hoglet67/ElectronFpga/pcb/README.md

# ElectronFpga/pcb

This is a PCB for the Electron ULA replacement project (the "Ultimate Electron Upgrade").

Stardot thread:
https://stardot.org.uk/forums/viewtopic.php?f=3&t=9223

Status: v1 board sent to fab!

Pictures
--------

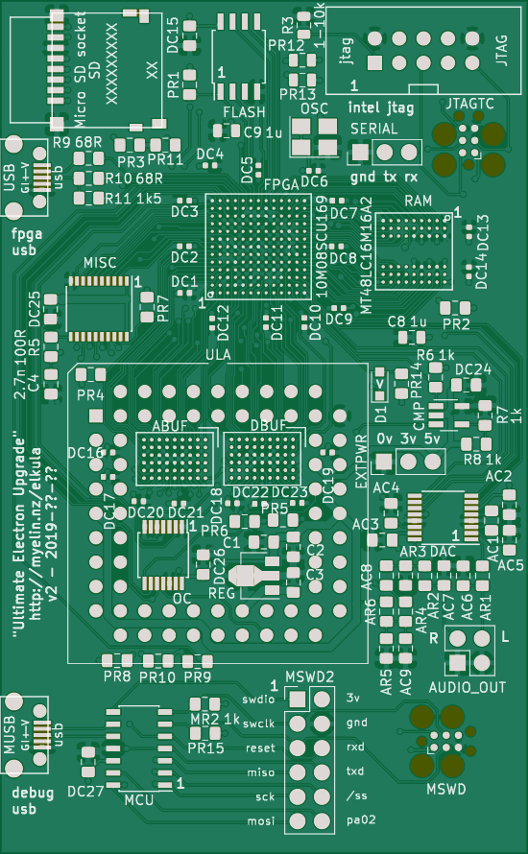
[picture p1: pcb/pcb-front.png]
PCB front


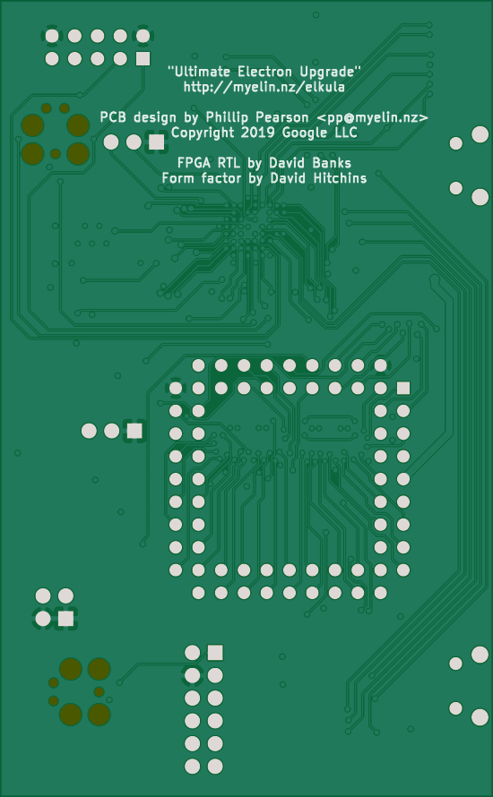
[picture p2: pcb/pcb-back.png]
PCB back
