hoglet67/ElectronFpga/rgb_to_vga_pcb/pcb-back.png

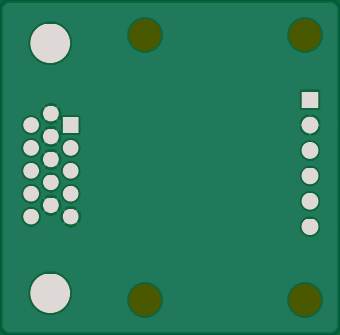
rgb_to_vga_pcb/pcb-back.png
