hoglet67/ElectronFpga/rgb_to_vga_pcb/pcb-front.png

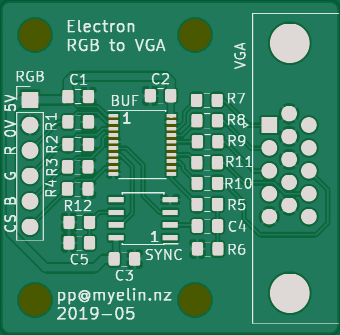
rgb_to_vga_pcb/pcb-front.png
