hoglet67/ElectronFpga/pcb/readable_bill_of_materials.txt

This is the human-readable bill of materials.
See bill_of_materials.txt for a terser version suitable for spreadsheet import.

DC1
- Value: 100n
- Description: Capacitor 0402: 100n
- KiCad package: Capacitor_SMD:C_0402_1005Metric

DC10
- Value: 100n
- Description: Capacitor 0402: 100n
- KiCad package: Capacitor_SMD:C_0402_1005Metric

DC11
- Value: 100n
- Description: Capacitor 0402: 100n
- KiCad package: Capacitor_SMD:C_0402_1005Metric

DC12
- Value: 100n
- Description: Capacitor 0402: 100n
- KiCad package: Capacitor_SMD:C_0402_1005Metric

DC13
- Value: 100n
- Description: Capacitor 0402: 100n
- KiCad package: Capacitor_SMD:C_0402_1005Metric

DC14
- Value: 100n
- Description: Capacitor 0402: 100n
- KiCad package: Capacitor_SMD:C_0402_1005Metric

DC16
- Value: 100n
- Description: Capacitor 0402: 100n
- KiCad package: Capacitor_SMD:C_0402_1005Metric

DC17
- Value: 100n
- Description: Capacitor 0402: 100n
- KiCad package: Capacitor_SMD:C_0402_1005Metric

DC18
- Value: 100n
- Description: Capacitor 0402: 100n
- KiCad package: Capacitor_SMD:C_0402_1005Metric

DC19
- Value: 100n
- Description: Capacitor 0402: 100n
- KiCad package: Capacitor_SMD:C_0402_1005Metric

DC2
- Value: 100n
- Description: Capacitor 0402: 100n
- KiCad package: Capacitor_SMD:C_0402_1005Metric

DC20
- Value: 100n
- Description: Capacitor 0402: 100n
- KiCad package: Capacitor_SMD:C_0402_1005Metric

DC21
- Value: 100n
- Description: Capacitor 0402: 100n
- KiCad package: Capacitor_SMD:C_0402_1005Metric

DC22
- Value: 100n
- Description: Capacitor 0402: 100n
- KiCad package: Capacitor_SMD:C_0402_1005Metric

DC23
- Value: 100n
- Description: Capacitor 0402: 100n
- KiCad package: Capacitor_SMD:C_0402_1005Metric

DC3
- Value: 100n
- Description: Capacitor 0402: 100n
- KiCad package: Capacitor_SMD:C_0402_1005Metric

DC4
- Value: 100n
- Description: Capacitor 0402: 100n
- KiCad package: Capacitor_SMD:C_0402_1005Metric

DC5
- Value: 100n
- Description: Capacitor 0402: 100n
- KiCad package: Capacitor_SMD:C_0402_1005Metric

DC6
- Value: 100n
- Description: Capacitor 0402: 100n
- KiCad package: Capacitor_SMD:C_0402_1005Metric

DC7
- Value: 100n
- Description: Capacitor 0402: 100n
- KiCad package: Capacitor_SMD:C_0402_1005Metric

DC8
- Value: 100n
- Description: Capacitor 0402: 100n
- KiCad package: Capacitor_SMD:C_0402_1005Metric

DC9
- Value: 100n
- Description: Capacitor 0402: 100n
- KiCad package: Capacitor_SMD:C_0402_1005Metric

DC15
- Value: 100n
- Description: Capacitor 0805: 100n
- KiCad package: Capacitor_SMD:C_0805_2012Metric_Pad1.15x1.40mm_HandSolder

DC24
- Value: 100n
- Description: Capacitor 0805: 100n
- KiCad package: Capacitor_SMD:C_0805_2012Metric_Pad1.15x1.40mm_HandSolder

DC25
- Value: 100n
- Description: Capacitor 0805: 100n
- KiCad package: Capacitor_SMD:C_0805_2012Metric_Pad1.15x1.40mm_HandSolder

DC26
- Value: 100n
- Description: Capacitor 0805: 100n
- KiCad package: Capacitor_SMD:C_0805_2012Metric_Pad1.15x1.40mm_HandSolder

DC27
- Value: 100n
- Description: Capacitor 0805: 100n
- KiCad package: Capacitor_SMD:C_0805_2012Metric_Pad1.15x1.40mm_HandSolder

AC8
- Value: 10u
- Description: Capacitor 0805: 10u
- KiCad package: Capacitor_SMD:C_0805_2012Metric_Pad1.15x1.40mm_HandSolder

AC9
- Value: 10u
- Description: Capacitor 0805: 10u
- KiCad package: Capacitor_SMD:C_0805_2012Metric_Pad1.15x1.40mm_HandSolder

C1
- Value: 10u
- Description: Capacitor 0805: 10u
- KiCad package: Capacitor_SMD:C_0805_2012Metric_Pad1.15x1.40mm_HandSolder

AC1
- Value: 1u
- Description: Capacitor 0805: 1u
- KiCad package: Capacitor_SMD:C_0805_2012Metric_Pad1.15x1.40mm_HandSolder

AC5
- Value: 1u
- Description: Capacitor 0805: 1u
- KiCad package: Capacitor_SMD:C_0805_2012Metric_Pad1.15x1.40mm_HandSolder

C2
- Value: 1u
- Description: Capacitor 0805: 1u
- KiCad package: Capacitor_SMD:C_0805_2012Metric_Pad1.15x1.40mm_HandSolder

C3
- Value: 1u
- Description: Capacitor 0805: 1u
- KiCad package: Capacitor_SMD:C_0805_2012Metric_Pad1.15x1.40mm_HandSolder

C8
- Value: 1u
- Description: Capacitor 0805: 1u
- KiCad package: Capacitor_SMD:C_0805_2012Metric

C9
- Value: 1u
- Description: Capacitor 0805: 1u
- KiCad package: Capacitor_SMD:C_0805_2012Metric

AC4
- Value: 2.2u
- Description: Capacitor 0805: 2.2u
- KiCad package: Capacitor_SMD:C_0805_2012Metric_Pad1.15x1.40mm_HandSolder

C4
- Value: 2.7n
- Description: Capacitor 0805: 2.7n
- KiCad package: Capacitor_SMD:C_0805_2012Metric_Pad1.15x1.40mm_HandSolder

AC6
- Value: 2.7n NF
- Description: Capacitor 0805: 2.7n NF
- KiCad package: Capacitor_SMD:C_0805_2012Metric_Pad1.15x1.40mm_HandSolder

AC7
- Value: 2.7n NF
- Description: Capacitor 0805: 2.7n NF
- KiCad package: Capacitor_SMD:C_0805_2012Metric_Pad1.15x1.40mm_HandSolder

AC2
- Value: 4.7u
- Description: Capacitor 0805: 4.7u
- KiCad package: Capacitor_SMD:C_0805_2012Metric_Pad1.15x1.40mm_HandSolder

AC3
- Value: 4.7u
- Description: Capacitor 0805: 4.7u
- KiCad package: Capacitor_SMD:C_0805_2012Metric_Pad1.15x1.40mm_HandSolder

D1
- Value: BAT54
- Description: Diode SOD323: BAT54
- KiCad package: Diode_SMD:D_SOD-323_HandSoldering

FLASH
- Value: W25Q128JVSIM
- Description: IC 128Mbit QSPI flash; https://www.digikey.com/product-detail/en/winbond-electronics/W25Q128JVSIM/W25Q128JVSIM-ND/6819721
- KiCad package: Package_SO:SOIJ-8_5.3x5.3mm_P1.27mm

MCU
- Value: atsamd11c
- Description: IC ARM MCU; https://www.digikey.com/product-detail/en/microchip-technology/ATSAMD11C14A-SSUT/ATSAMD11C14A-SSUTCT-ND
- KiCad package: Package_SO:SOIC-14_3.9x8.7mm_P1.27mm

DAC
- Value: WM8524CGEDT
- Description: IC Audio DAC; https://www.digikey.com/product-detail/en/cirrus-logic-inc/WM8524CGEDT/598-2458-ND
- KiCad package: Package_SO:TSSOP-16_4.4x5mm_P0.65mm

CMP
- Value: MIC7221YM5-TR
- Description: IC Comparator; https://www.digikey.com/product-detail/en/microchip-technology/MIC7221YM5-TR/576-2901-1-ND
- KiCad package: Package_TO_SOT_SMD:SOT-23-5_HandSoldering

FPGA
- Value: 10M08SCU169
- Description: IC FPGA Intel Max 10; https://www.digikey.com/product-detail/en/10M08SCU169C8G/544-3270-ND
- KiCad package: myelin-kicad:intel_ubga169

REG
- Value: AP7365-33YG-XX
- Description: IC LDO 3.3V regulator; https://www.digikey.com/products/en?keywords=AP7365-33YG-13DICT-ND
- KiCad package: Package_TO_SOT_SMD:SOT-89-3

RAM
- Value: MT48LC16M16A2
- Description: IC SDRAM 32MB; MT48LC16M16A2F4-6A:GTR
- KiCad package: myelin-kicad:sdram_54tfbga

ABUF
- Value: 74LVTH162245ZRDR
- Description: IC buffer 16-bit; https://www.digikey.com/product-detail/en/texas-instruments/74LVTH162245ZRDR/296-16878-1-ND
- KiCad package: myelin-kicad:ti_zrd_54_pbga

DBUF
- Value: 74LVTH162245ZRDR
- Description: IC buffer 16-bit; https://www.digikey.com/product-detail/en/texas-instruments/74LVTH162245ZRDR/296-16878-1-ND
- KiCad package: myelin-kicad:ti_zrd_54_pbga

OC
- Value: 74HCT125PW
- Description: IC buffer 4-bit OC; https://www.digikey.com/product-detail/en/nexperia-usa-inc/74HCT125PW112/1727-6443-ND
- KiCad package: Package_SO:TSSOP-14_4.4x5mm_P0.65mm

MISC
- Value: 74HCT245PW
- Description: IC buffer 8-bit; https://www.digikey.com/product-detail/en/nexperia-usa-inc/74HCT245PW118/1727-6353-1-ND
- KiCad package: Package_SO:SSOP-20_4.4x6.5mm_P0.65mm

OSC
- Value: osc
- Description: IC oscillator 16MHz; https://www.digikey.com/product-detail/en/microchip-technology/DSC1001CL1-016.0000/DSC1001CL1-016.0000-ND
- KiCad package: Oscillator:Oscillator_SMD_Abracon_ASE-4Pin_3.2x2.5mm_HandSoldering

AUDIO_OUT
- Value: audio out
- Description: Pin header
- KiCad package: Connector_PinHeader_2.54mm:PinHeader_2x02_P2.54mm_Vertical

SERIAL
- Value: fpga serial port
- Description: Pin header
- KiCad package: Connector_PinHeader_2.54mm:PinHeader_1x03_P2.54mm_Vertical

JTAG
- Value: jtag
- Description: Pin header
- KiCad package: myelin-kicad:jtag_shrouded_2x5

MSWD2
- Value: swd
- Description: Pin header
- KiCad package: Connector_PinHeader_2.54mm:PinHeader_2x06_P2.54mm_Vertical

EXTPWR
- Value: ext pwr
- Description: Pin header - 1x3 0.1 inch male
- KiCad package: Connector_PinHeader_2.54mm:PinHeader_1x03_P2.54mm_Vertical

ULA
- Value: ULA header
- Description: Pin header - round - to plug into an Acorn Electron ULA socket
- KiCad package: modified-kicad:PLCC-68_THT-Socket-Electron-ULA

R3
- Value: 1-10k
- Description: Resistor 0805: 1-10k
- KiCad package: Resistor_SMD:R_0805_2012Metric

R5
- Value: 100R
- Description: Resistor 0805: 100R
- KiCad package: Resistor_SMD:R_0805_2012Metric_Pad1.15x1.40mm_HandSolder

AR4
- Value: 10k
- Description: Resistor 0805: 10k
- KiCad package: Resistor_SMD:R_0805_2012Metric_Pad1.15x1.40mm_HandSolder

AR5
- Value: 10k
- Description: Resistor 0805: 10k
- KiCad package: Resistor_SMD:R_0805_2012Metric_Pad1.15x1.40mm_HandSolder

AR6
- Value: 10k
- Description: Resistor 0805: 10k
- KiCad package: Resistor_SMD:R_0805_2012Metric_Pad1.15x1.40mm_HandSolder

PR1
- Value: 10k
- Description: Resistor 0805: 10k
- KiCad package: Resistor_SMD:R_0805_2012Metric_Pad1.15x1.40mm_HandSolder

PR10
- Value: 10k
- Description: Resistor 0805: 10k
- KiCad package: Resistor_SMD:R_0805_2012Metric_Pad1.15x1.40mm_HandSolder

PR12
- Value: 10k
- Description: Resistor 0805: 10k
- KiCad package: Resistor_SMD:R_0805_2012Metric

PR13
- Value: 10k
- Description: Resistor 0805: 10k
- KiCad package: Resistor_SMD:R_0805_2012Metric

PR14
- Value: 10k
- Description: Resistor 0805: 10k
- KiCad package: Resistor_SMD:R_0805_2012Metric_Pad1.15x1.40mm_HandSolder

PR15
- Value: 10k
- Description: Resistor 0805: 10k
- KiCad package: Resistor_SMD:R_0805_2012Metric_Pad1.15x1.40mm_HandSolder

PR2
- Value: 10k
- Description: Resistor 0805: 10k
- KiCad package: Resistor_SMD:R_0805_2012Metric_Pad1.15x1.40mm_HandSolder

PR3
- Value: 10k
- Description: Resistor 0805: 10k
- KiCad package: Resistor_SMD:R_0805_2012Metric_Pad1.15x1.40mm_HandSolder

PR4
- Value: 10k
- Description: Resistor 0805: 10k
- KiCad package: Resistor_SMD:R_0805_2012Metric_Pad1.15x1.40mm_HandSolder

PR5
- Value: 10k
- Description: Resistor 0805: 10k
- KiCad package: Resistor_SMD:R_0805_2012Metric_Pad1.15x1.40mm_HandSolder

PR6
- Value: 10k
- Description: Resistor 0805: 10k
- KiCad package: Resistor_SMD:R_0805_2012Metric_Pad1.15x1.40mm_HandSolder

PR7
- Value: 10k
- Description: Resistor 0805: 10k
- KiCad package: Resistor_SMD:R_0805_2012Metric_Pad1.15x1.40mm_HandSolder

PR8
- Value: 10k
- Description: Resistor 0805: 10k
- KiCad package: Resistor_SMD:R_0805_2012Metric_Pad1.15x1.40mm_HandSolder

PR9
- Value: 10k
- Description: Resistor 0805: 10k
- KiCad package: Resistor_SMD:R_0805_2012Metric_Pad1.15x1.40mm_HandSolder

AR3
- Value: 10k NF
- Description: Resistor 0805: 10k NF
- KiCad package: Resistor_SMD:R_0805_2012Metric_Pad1.15x1.40mm_HandSolder

PR11
- Value: 10k NF
- Description: Resistor 0805: 10k NF
- KiCad package: Resistor_SMD:R_0805_2012Metric_Pad1.15x1.40mm_HandSolder

MR2
- Value: 1k
- Description: Resistor 0805: 1k
- KiCad package: Resistor_SMD:R_0805_2012Metric_Pad1.15x1.40mm_HandSolder

R6
- Value: 1k
- Description: Resistor 0805: 1k
- KiCad package: Resistor_SMD:R_0805_2012Metric_Pad1.15x1.40mm_HandSolder

R7
- Value: 1k
- Description: Resistor 0805: 1k
- KiCad package: Resistor_SMD:R_0805_2012Metric_Pad1.15x1.40mm_HandSolder

R8
- Value: 1k
- Description: Resistor 0805: 1k
- KiCad package: Resistor_SMD:R_0805_2012Metric_Pad1.15x1.40mm_HandSolder

R11
- Value: 1k5
- Description: Resistor 0805: 1k5
- KiCad package: Resistor_SMD:R_0805_2012Metric_Pad1.15x1.40mm_HandSolder

AR1
- Value: 560R NF
- Description: Resistor 0805: 560R NF
- KiCad package: Resistor_SMD:R_0805_2012Metric_Pad1.15x1.40mm_HandSolder

AR2
- Value: 560R NF
- Description: Resistor 0805: 560R NF
- KiCad package: Resistor_SMD:R_0805_2012Metric_Pad1.15x1.40mm_HandSolder

R10
- Value: 68R
- Description: Resistor 0805: 68R
- KiCad package: Resistor_SMD:R_0805_2012Metric_Pad1.15x1.40mm_HandSolder

R9
- Value: 68R
- Description: Resistor 0805: 68R
- KiCad package: Resistor_SMD:R_0805_2012Metric_Pad1.15x1.40mm_HandSolder

MUSB
- Value: usb
- Description: Socket Micro USB, Molex 1050170001; https://www.digikey.com/products/en?keywords=WM1399CT-ND
- KiCad package: myelin-kicad:micro_usb_b_smd_molex

USB
- Value: usb
- Description: Socket Micro USB, Molex 1050170001; https://www.digikey.com/products/en?keywords=WM1399CT-ND
- KiCad package: myelin-kicad:micro_usb_b_smd_molex

SD
- Value: Micro SD socket
- Description: Socket micro SD; https://www.digikey.com/products/en?keywords=HR1941CT-ND
- KiCad package: myelin-kicad:hirose_micro_sd_card_socket
