hoglet67/ElectronFpga/(list of files, drawings)

Other design files:
pcb/common/Makefile.pcb
