hoglet67/ElectronFpga/AtomBusMon/kicad/6809e/v1/6809e_adapter.kicad_pcb

## KiCad design AtomBusMon/kicad/6809e/v1/6809e_adapter.kicad_pcb (2020-01-03)

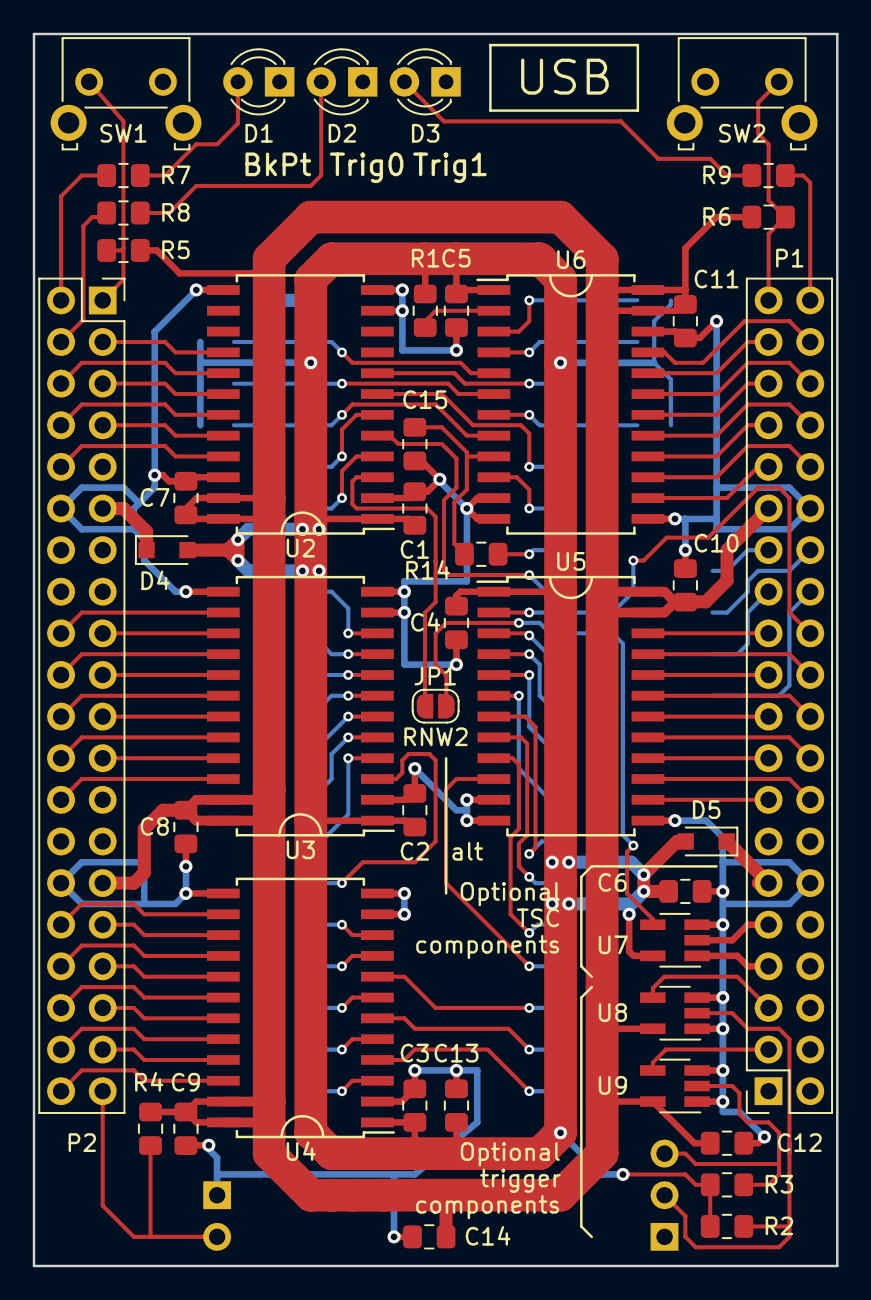
[picture p5: board 6809e_adapter.kicad_pcb from above]

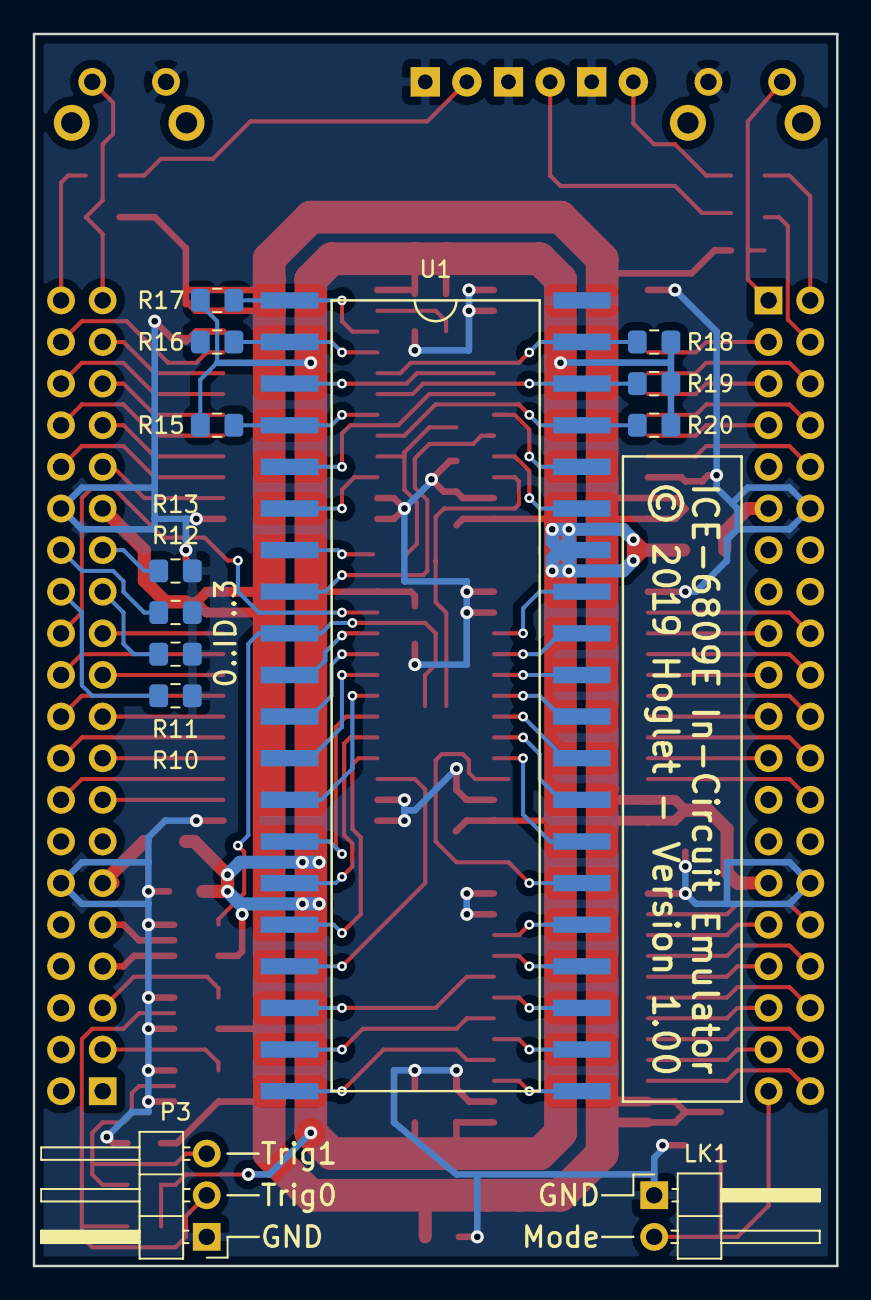
[picture p6: board 6809e_adapter.kicad_pcb from below]

Board: 2 copper layers, 49.0 x 75.2 mm, 56 parts (13 on the bottom side), 107 nets.

Parts:
C1, C2, C3, C4, C5, C6, C7, C8, C9, C10, C11, C12: 100nF; C_0805_2012Metric_Pad1.15x1.40mm_HandSolder
C13, C14: 10uF; C_0805_2012Metric_Pad1.15x1.40mm_HandSolder
C15: 0; C_0805_2012Metric_Pad1.15x1.40mm_HandSolder
D1, D2, D3: LED; LED_D3.0mm
D4, D5: MBR130; D_SOD-323_HandSoldering
JP1: Jumper_2_Open; SolderJumper-2_P1.3mm_Open_RoundedPad1.0x1.5mm
LK1: Conn_01x02; PinHeader_1x02_P2.54mm_Horizontal
P1, P2: Conn_02x20_Odd_Even; PinSocket_2x20_P2.54mm_Vertical
P3: Conn_01x03; PinHeader_1x03_P2.54mm_Horizontal
R1, R2, R3, R4, R5, R6, R15, R16, R17, R18, R19, R20: 22K; R_0805_2012Metric_Pad1.15x1.40mm_HandSolder
R7, R8, R9: 330; R_0805_2012Metric_Pad1.15x1.40mm_HandSolder
R10, R11, R12, R13, R14: 0; R_0805_2012Metric_Pad1.15x1.40mm_HandSolder
SW1, SW2: SW_Push; SW_Tactile_SKHH_Angled
U1: MC6809E; dip40_smt_header
U2, U3, U4, U5, U6: 74LVC4245; SOIC-24W_7.5x15.4mm_Pitch1.27mm
U7, U8, U9: 74LV1T125; SOT-23-5_HandSoldering

Connections:
/3V3: C7.1, C8.1, C9.1, C10.1, C11.1, C12.1, C14.1, P1.29, P2.29, R4.1, R5.1, R6.1, U2.23, U2.24, U3.23, U3.24, U4.23, U4.24, U5.23, U5.24, U6.23, U6.24, U8.5, U9.5
/5V: C1.1, C2.1, C3.1, C4.1, C5.1, C6.1, C13.1, D4.2, D5.2, R1.1, R2.1, R3.1, R15.1, R17.1, R18.1, R19.1, R20.1, U1.7, U2.1, U3.1, U4.1, U5.1, U6.1, U7.5
/A0: U1.8, U3.10
/A1: U1.9, U3.9
/A2: U1.10, U3.8
/A3: U1.11, U3.7
/A4: U1.12, U3.6
/A5: U1.13, U3.5
/A6: U1.14, U3.4
/A7: U1.15, U3.3
/A8: U1.16, U4.10
/A9: U1.17, U4.9
/A10: U1.18, U4.7
/A11: U1.19, U4.5
/A12: U1.20, U4.3
/A13: U1.21, U4.4
/A14: U1.22, U4.6
/A15: U1.23, U4.8
/AVMA: U1.36, U2.7
/BA: U1.6, U2.4
/BS: U1.5, U2.6
/BUSY: U1.33, U2.5
/D0: U1.31, U5.3
/D1: U1.30, U5.4
/D2: U1.29, U5.5
/D3: U1.28, U5.6
/D4: U1.27, U5.7
/D5: U1.26, U5.8
/D6: U1.25, U5.9
/D7: U1.24, U5.10
/E: R14.2, U1.34
/FILTERED_E: C15.1, R14.1, U6.9
/GND: C1.2, C2.2, C3.2, C4.2, C5.2, C6.2, C7.2, C8.2, C9.2, C10.2, C11.2, C12.2, C13.2, C14.2, C15.2, D1.1, D2.1, D3.1, LK1.1, P1.12, P1.30, P2.12, P2.30, P3.1, R10.1, R11.1, R12.1, R13.1, R16.2, SW1.2, SW2.1, U1.1, U2.2, U2.11, U2.12, U2.13, U2.22, U3.2, U3.11, U3.12, U3.13, U4.2, U4.11, U4.12, U4.13, U5.11, U5.12, U5.13, U6.11, U6.12, U6.13, U6.22, U7.3, U8.1, U8.3, U9.1, U9.3
/ID0: P1.26, R10.2
/ID1: P1.25, R11.2
/ID2: P1.28, R12.2
/ID3: P1.27, R13.2
/JUMPER: LK1.2, P2.39, R4.2
/LED1: P2.2, R7.1
/LED2: P2.4, R8.1
/LED3: P1.40, R9.1
/LIC: U1.38, U2.8
/LV_A0: P2.18, U3.14
/LV_A1: P2.17, U3.15
/LV_A2: P2.20, U3.16
/LV_A3: P2.19, U3.17
/LV_A4: P2.22, U3.18
/LV_A5: P2.21, U3.19
/LV_A6: P2.24, U3.20
/LV_A7: P2.23, U3.21
/LV_A8: P2.32, U4.14
/LV_A9: P2.31, U4.15
/LV_A10: P2.33, U4.17
/LV_A11: P2.35, U4.19
/LV_A12: P2.37, U4.21
/LV_A13: P2.38, U4.20
/LV_A14: P2.36, U4.18
/LV_A15: P2.34, U4.16
/LV_AVMA: P2.6, U2.17
/LV_BA: P2.7, U2.20
/LV_BS: P2.5, U2.18
/LV_BUSY: P2.8, U2.19
/LV_D0: P1.22, U5.21
/LV_D1: P1.21, U5.20
/LV_D2: P1.20, U5.19
/LV_D3: P1.19, U5.18
/LV_D4: P1.18, U5.17
/LV_D5: P1.17, U5.16
/LV_D6: P1.16, U5.15
/LV_D7: P1.15, U5.14
/LV_DIRD: P1.24, U5.2
/LV_E: P1.32, U6.15
/LV_LIC: P2.3, U2.16
/LV_OEAH: P2.40, U4.22
/LV_OEAL: P2.26, U3.22
/LV_OED: P1.23, U5.22
/LV_OERW: P1.7, U7.1
/LV_Q: P1.31, U6.14
/LV_RnW: P1.9, U7.2
/LV_RnW2: P2.10, U2.21
/LV_TRIG0: P1.5, U8.4
/LV_TRIG1: P1.3, U9.4
/LV_TSC: P1.37, U6.20
/LV_nFIRQ: P1.33, U6.16
/LV_nHALT: P1.38, U6.21
/LV_nIRQ: P1.35, U6.18
/LV_nNMI: P1.36, U6.19
/LV_nRST: P1.34, U6.17
/Q: U1.35, U6.10
/RnW: JP1.2, U1.32, U7.4
/RnW2: JP1.1, U2.3
/SW1: P2.1, R5.2, SW1.1
/SW2: P1.39, R6.2, SW2.2
/TRIG0: P3.2, R2.2, U8.2
/TRIG1: P3.3, R3.2, U9.2
/TSC: R16.1, U1.39, U6.4
/VIN1: D5.1, P1.11
/VIN2: D4.1, P2.11
/nFIRQ: R20.2, U1.4, U6.8
/nHALT: R17.2, U1.40, U6.3
/nIRQ: R19.2, U1.3, U6.6
/nNMI: R18.2, U1.2, U6.5
/nRST: R15.2, U1.37, U6.7
unnamed: D1.2, R7.2
unnamed: D2.2, R8.2
unnamed: D3.2, R9.2
unnamed: R1.2, U6.2
