hoglet67/ElectronFpga/AtomBusMon/kicad/z80/v1/z80_adapter.kicad_pcb

## KiCad design AtomBusMon/kicad/z80/v1/z80_adapter.kicad_pcb (2020-01-03)

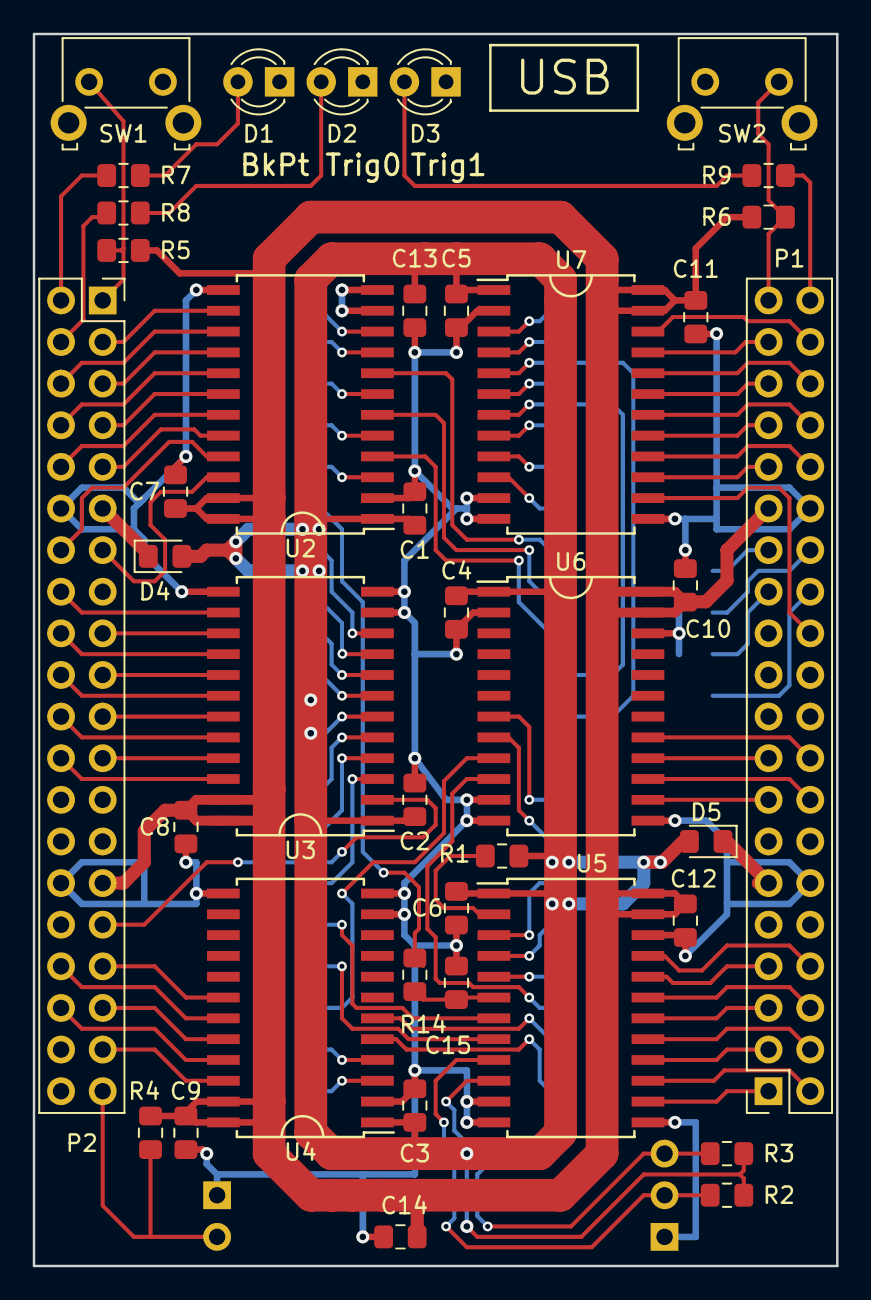
[picture p7: board z80_adapter.kicad_pcb from above]

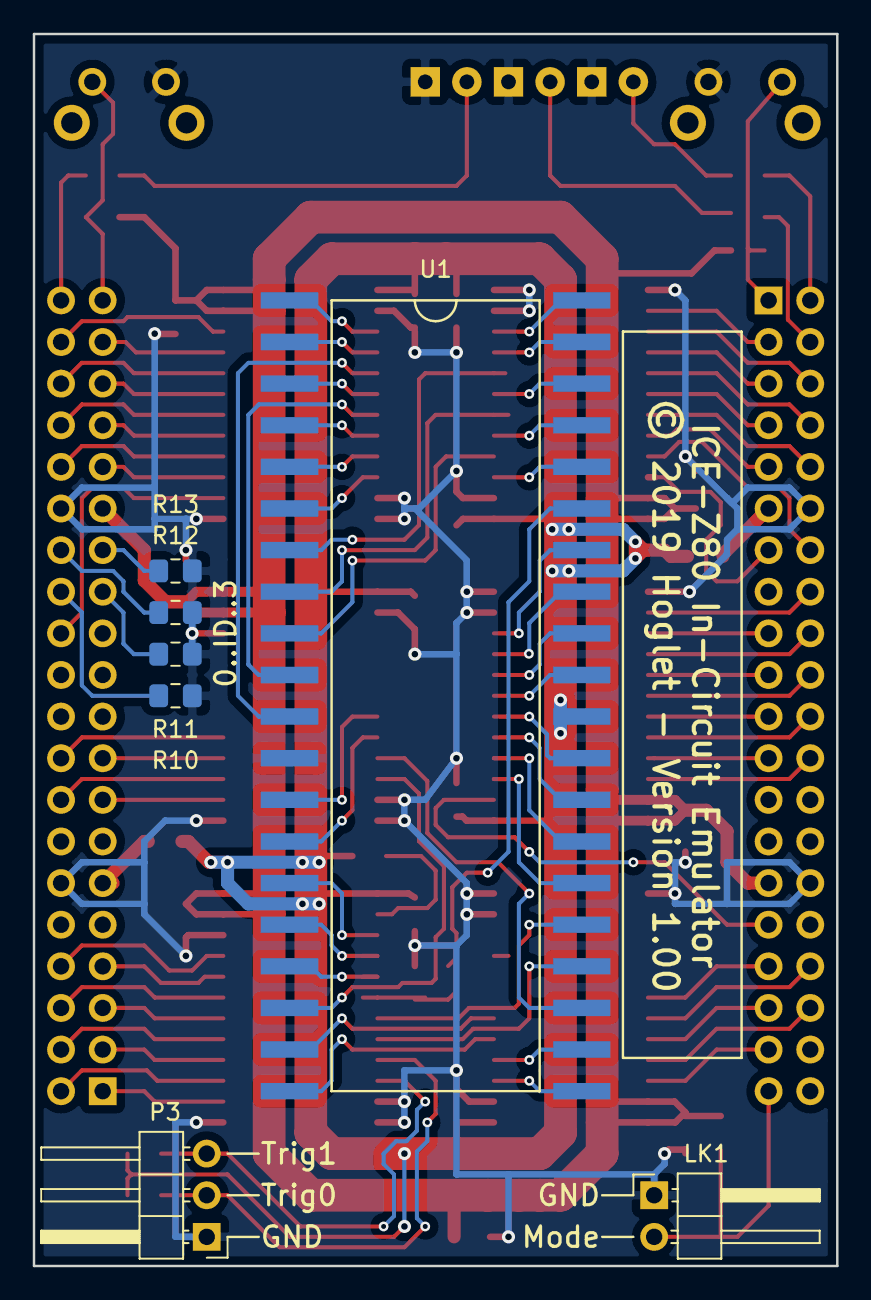
[picture p8: board z80_adapter.kicad_pcb from below]

Board: 2 copper layers, 49.0 x 75.2 mm, 47 parts (7 on the bottom side), 105 nets.

Parts:
C1, C2, C3, C4, C5, C6, C7, C8, C9, C10, C11, C12: 100nF; C_0805_2012Metric_Pad1.15x1.40mm_HandSolder
C13, C14: 10uF; C_0805_2012Metric_Pad1.15x1.40mm_HandSolder
C15: 0pF; C_0805_2012Metric_Pad1.15x1.40mm_HandSolder
D1, D2, D3: LED; LED_D3.0mm
D4, D5: MBR130; D_0805_2012Metric_Pad1.15x1.40mm_HandSolder
LK1: Conn_01x02; PinHeader_1x02_P2.54mm_Horizontal
P1, P2: Conn_02x20_Odd_Even; PinSocket_2x20_P2.54mm_Vertical
P3: Conn_01x03; PinHeader_1x03_P2.54mm_Horizontal
R1, R2, R3, R4, R5, R6: 22K; R_0805_2012Metric_Pad1.15x1.40mm_HandSolder
R7, R8, R9: 330; R_0805_2012Metric_Pad1.15x1.40mm_HandSolder
R10, R11, R12, R13, R14: 0; R_0805_2012Metric_Pad1.15x1.40mm_HandSolder
SW1, SW2: SW_Push; SW_Tactile_SKHH_Angled
U1: Z80CPU; dip40_smt_header
U2, U3, U4, U5, U6, U7: 74LVC4245; SOIC-24W_7.5x15.4mm_Pitch1.27mm

Connections:
/3V3: C7.1, C8.1, C9.1, C10.1, C11.1, C12.1, C14.1, P1.29, P2.29, R4.1, R5.1, R6.1, U2.23, U2.24, U3.23, U3.24, U4.23, U4.24, U5.23, U5.24, U6.23, U6.24, U7.23, U7.24
/5V: C1.1, C2.1, C3.1, C4.1, C5.1, C6.1, C13.1, D4.2, D5.2, R1.1, R2.1, R3.1, U1.11, U2.1, U3.1, U4.1, U5.1, U6.1, U7.1
/A0: U1.30, U7.5
/A1: U1.31, U7.7
/A2: U1.32, U2.4
/A3: U1.33, U2.6
/A4: U1.34, U2.8
/A5: U1.35, U7.10
/A6: U1.36, U7.9
/A7: U1.37, U7.8
/A8: U1.38, U7.6
/A9: U1.39, U7.4
/A10: U1.40, U7.3
/A11: U1.1, U2.10
/A12: U1.2, U2.9
/A13: U1.3, U2.7
/A14: U1.4, U2.5
/A15: U1.5, U2.3
/BUSACK: U1.23, U6.10
/BUSRQ: U1.25, U5.4
/CLK: R14.2, U1.6
/D0: U1.14, U3.4
/D1: U1.15, U3.3
/D2: U1.12, U3.6
/D3: U1.8, U3.9
/D4: U1.7, U3.10
/D5: U1.9, U3.8
/D6: U1.10, U3.7
/D7: U1.13, U3.5
/FILTERED_CLK: C15.1, R14.1, U5.6
/GND: C1.2, C2.2, C3.2, C4.2, C5.2, C6.2, C7.2, C8.2, C9.2, C10.2, C11.2, C12.2, C13.2, C14.2, C15.2, D1.1, D2.1, D3.1, LK1.1, P1.12, P1.30, P2.12, P2.30, P3.1, R10.1, R11.1, R12.1, R13.1, SW1.2, SW2.1, U1.29, U2.2, U2.11, U2.12, U2.13, U3.11, U3.12, U3.13, U4.2, U4.11, U4.12, U4.13, U5.11, U5.12, U5.13, U5.22, U6.2, U6.11, U6.12, U6.13, U6.22, U7.2, U7.11, U7.12, U7.13
/HALT: U1.18, U6.9
/ID0: P1.26, R10.2
/ID1: P1.25, R11.2
/ID2: P1.28, R12.2
/ID3: P1.27, R13.2
/INT: U1.16, U5.7
/IORQ: U1.20, U4.3
/JUMPER: LK1.2, P2.39, R4.2
/LED1: P2.2, R7.1
/LED2: P2.4, R8.1
/LED3: P1.40, R9.1
/LV_A0: P1.35, U7.19
/LV_A1: P1.33, U7.17
/LV_A2: P2.9, U2.20
/LV_A3: P2.7, U2.18
/LV_A4: P2.5, U2.16
/LV_A5: P1.24, U7.14
/LV_A6: P1.31, U7.15
/LV_A7: P1.32, U7.16
/LV_A8: P1.34, U7.18
/LV_A9: P1.36, U7.20
/LV_A10: P1.37, U7.21
/LV_A11: P2.3, U2.14
/LV_A12: P2.6, U2.15
/LV_A13: P2.8, U2.17
/LV_A14: P2.10, U2.19
/LV_A15: P2.14, U2.21
/LV_BUSACK: P1.15, U6.14
/LV_BUSRQ: P1.7, U5.20
/LV_CLK: P1.5, U5.18
/LV_D0: P2.22, U3.20
/LV_D1: P2.23, U3.21
/LV_D2: P2.20, U3.18
/LV_D3: P2.17, U3.15
/LV_D4: P2.16, U3.14
/LV_D5: P2.18, U3.16
/LV_D6: P2.19, U3.17
/LV_D7: P2.21, U3.19
/LV_DIRD: P2.31, U3.2
/LV_HALT: P1.16, U6.15
/LV_INT: P1.4, U5.17
/LV_IORQ: P2.36, U4.21
/LV_M1: P1.17, U6.16
/LV_MREQ: P2.35, U4.20
/LV_NMI: P1.3, U5.16
/LV_OEA1: P2.13, U2.22
/LV_OEA2: P1.38, U7.22
/LV_OEC: P2.37, U4.22
/LV_OED: P2.24, U3.22
/LV_RD: P2.34, U4.19
/LV_RESET: P1.8, U5.21
/LV_RFSH: P1.18, U6.17
/LV_TRIG0: P1.2, U5.15
/LV_TRIG1: P1.1, U5.14
/LV_WAIT: P1.6, U5.19
/LV_WR: P2.33, U4.18
/M1: U1.27, U6.8
/MREQ: U1.19, U4.4
/NMI: U1.17, U5.8
/RD: U1.21, U4.5
/RESET: U1.26, U5.3
/RFSH: U1.28, U6.7
/SW1: P2.1, R5.2, SW1.1
/SW2: P1.39, R6.2, SW2.2
/TRIG0: P3.2, R2.2, U5.9
/TRIG1: P3.3, R3.2, U5.10
/VIN1: D5.1, P1.11
/VIN2: D4.1, P2.11
/WAIT: U1.24, U5.5
/WR: U1.22, U4.6
unnamed: D1.2, R7.2
unnamed: D2.2, R8.2
unnamed: D3.2, R9.2
unnamed: R1.2, U5.2
