hoglet67/ElectronFpga/pcb/max10_electron_ula.kicad_pcb

## KiCad design pcb/max10_electron_ula.kicad_pcb (2020-06-28)

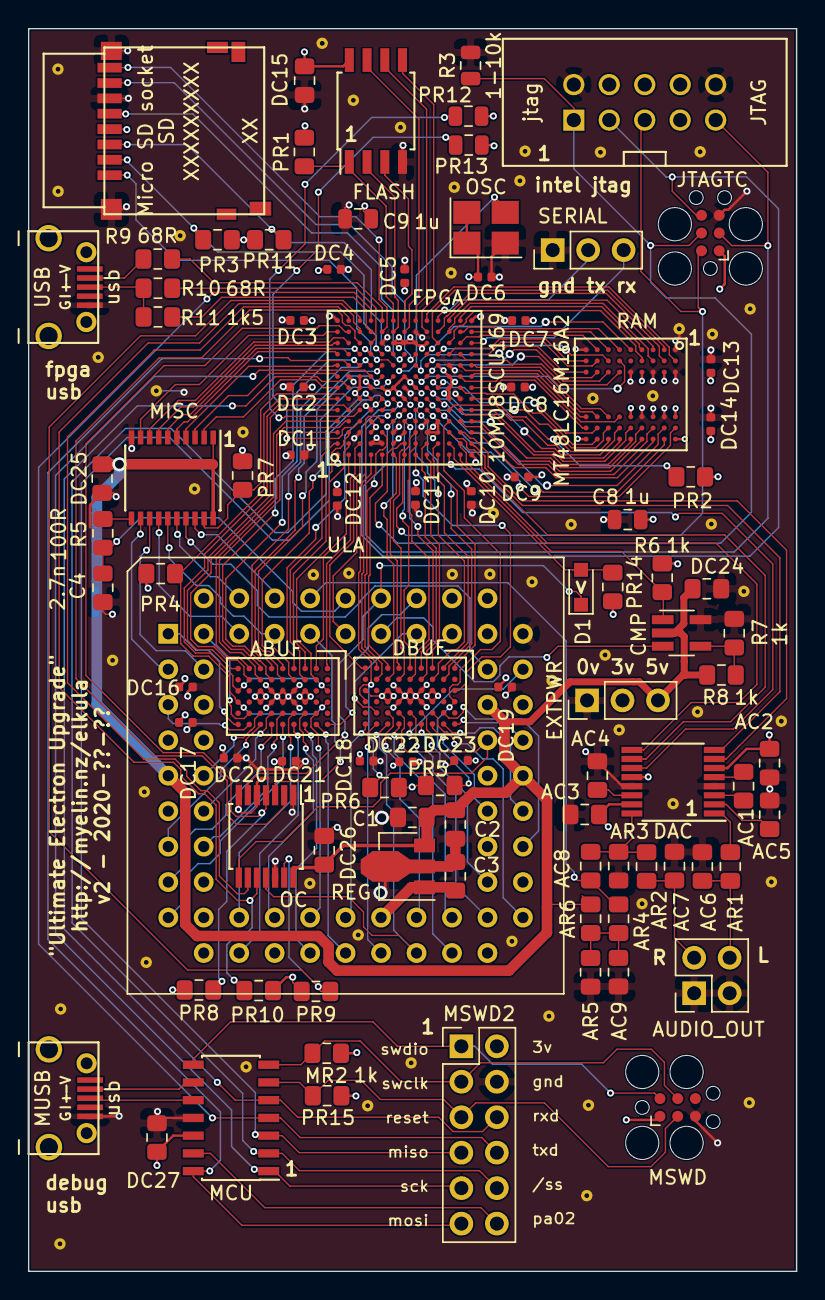
[picture p9: board max10_electron_ula.kicad_pcb from above]

Board: 4 copper layers, 55.0 x 89.0 mm, 149 parts (0 on the bottom side), 194 nets.

Parts:
ABUF: 74LVTH162245ZRDR; ti_zrd_54_pbga
AC1, AC5: 1u; C_0805_2012Metric_Pad1.15x1.40mm_HandSolder
AC2, AC3: 4.7u; C_0805_2012Metric_Pad1.15x1.40mm_HandSolder
AC4: 2.2u; C_0805_2012Metric_Pad1.15x1.40mm_HandSolder
AC6, AC7: 2.7n NF; C_0805_2012Metric_Pad1.15x1.40mm_HandSolder
AC8, AC9: 10u; C_0805_2012Metric_Pad1.15x1.40mm_HandSolder
AR1, AR2: 560R NF; R_0805_2012Metric_Pad1.15x1.40mm_HandSolder
AR3: 10k NF; R_0805_2012Metric_Pad1.15x1.40mm_HandSolder
AR4, AR5, AR6: 10k; R_0805_2012Metric_Pad1.15x1.40mm_HandSolder
AUDIO_OUT: audio out; PinHeader_2x02_P2.54mm_Vertical
C1: 10u; C_0805_2012Metric_Pad1.15x1.40mm_HandSolder
C2, C3: 1u; C_0805_2012Metric_Pad1.15x1.40mm_HandSolder
C4: 2.7n; C_0805_2012Metric_Pad1.15x1.40mm_HandSolder
C8, C9: 1u; C_0805_2012Metric
CMP: MIC7221YM5-TR; SOT-23-5_HandSoldering
D1: BAT54; D_SOD-323_HandSoldering
DAC: WM8524CGEDT; TSSOP-16_4.4x5mm_P0.65mm
DBUF: 74LVTH162245ZRDR; ti_zrd_54_pbga
DC1, DC2, DC3, DC4, DC5, DC6, DC7, DC8, DC9, DC10, DC11, DC12, DC13, DC14, DC16, DC17, DC18, DC19, DC20, DC21, DC22, DC23: 100n; C_0402_1005Metric
DC15, DC24, DC25, DC26, DC27: 100n; C_0805_2012Metric_Pad1.15x1.40mm_HandSolder
EXTPWR: ext pwr; PinHeader_1x03_P2.54mm_Vertical
FLASH: W25Q128JVSIM; SOIJ-8_5.3x5.3mm_P1.27mm
FPGA: 10M08SCU169; intel_ubga169
JTAG: jtag; jtag_shrouded_2x5
JTAGTC: jtagtc; Tag-Connect_TC2030-IDC-FP_2x03_P1.27mm_Vertical
MCU: atsamd11c; SOIC-14_3.9x8.7mm_P1.27mm
MISC: 74HCT245PW; SSOP-20_4.4x6.5mm_P0.65mm
MR2: 1k; R_0805_2012Metric_Pad1.15x1.40mm_HandSolder
MSWD: swd; Tag-Connect_TC2030-IDC-FP_2x03_P1.27mm_Vertical
MSWD2: swd; PinHeader_2x06_P2.54mm_Vertical
MUSB: usb; micro_usb_b_smd_molex
OC: 74HCT125PW; TSSOP-14_4.4x5mm_P0.65mm
OSC: osc; Oscillator_SMD_Abracon_ASE-4Pin_3.2x2.5mm_HandSoldering
PR1, PR2, PR3, PR4, PR5, PR6, PR7, PR8, PR9, PR10, PR14, PR15: 10k; R_0805_2012Metric_Pad1.15x1.40mm_HandSolder
PR11: 10k NF; R_0805_2012Metric_Pad1.15x1.40mm_HandSolder
PR12, PR13: 10k; R_0805_2012Metric
R3: 1-10k; R_0805_2012Metric
R5: 100R; R_0805_2012Metric_Pad1.15x1.40mm_HandSolder
R6, R7, R8: 1k; R_0805_2012Metric_Pad1.15x1.40mm_HandSolder
R9, R10: 68R; R_0805_2012Metric_Pad1.15x1.40mm_HandSolder
R11: 1k5; R_0805_2012Metric_Pad1.15x1.40mm_HandSolder
RAM: MT48LC16M16A2; sdram_54tfbga
REG: AP7365-33YG-XX; SOT-89-3
SD: Micro SD socket; hirose_micro_sd_card_socket
SERIAL: fpga serial port; PinHeader_1x03_P2.54mm_Vertical
ULA: ULA header; PLCC-68_THT-Socket-Electron-ULA
USB: usb; micro_usb_b_smd_molex
staple_single1, staple_single2, staple_single3, staple_single4, staple_single5, staple_single6, staple_single7, staple_single8, staple_single9, staple_single10, staple_single11, staple_single12, staple_single13, staple_single14, staple_single15, staple_single16, staple_single17, staple_single18, staple_single19, staple_single20, staple_single21, staple_single22, staple_single23, staple_single24, staple_single25, staple_single26, staple_single27, staple_single28, staple_single29, staple_single30, staple_single31, staple_single32, staple_single33, staple_single34, staple_single35, staple_single36, staple_single37, staple_single38, staple_single39, staple_single40, staple_single41, staple_single42, staple_single43, staple_single44, staple_single45, staple_single46, staple_single47, staple_single48, staple_single49, staple_single50, staple_single51, staple_single52, staple_single53: via_single

Connections:
3V3: ABUF.C3, ABUF.C4, ABUF.G3, ABUF.G4, AC2.1, AC3.1, C3.1, C8.1, C9.1, DAC.6, DAC.12, DAC.15, DBUF.C3, DBUF.C4, DBUF.G3, DBUF.G4, DBUF.J3, DC1.1, DC2.1, DC3.1, DC4.1, DC5.1, DC6.1, DC7.1, DC8.1, DC9.1, DC10.1, DC11.1, DC12.1, DC13.1, DC14.1, DC15.1, DC16.2, DC17.2, DC18.2, DC19.2, DC20.2, DC21.2, DC22.2, DC23.2, DC27.2, EXTPWR.2, FLASH.8, FPGA.C6, FPGA.C7, FPGA.C8, FPGA.D3, FPGA.D4, FPGA.D10, FPGA.E7, FPGA.F2, FPGA.F7, FPGA.F11, FPGA.G3, FPGA.G6, FPGA.G8, FPGA.G11, FPGA.H7, FPGA.H11, FPGA.J3, FPGA.J11, FPGA.K3, FPGA.K4, FPGA.K9, FPGA.L6, FPGA.L7, FPGA.L8, JTAG.4, JTAGTC.1, MCU.12, MR2.2, MSWD.1, MSWD2.2, OSC.1, OSC.4, PR1.2, PR2.2, PR3.2, PR4.2, PR5.2, PR6.2, PR7.2, PR8.2, PR9.2, PR10.2, PR11.1, PR12.2, PR13.2, PR14.1, PR15.2, R6.2, RAM.A7, RAM.A9, RAM.B3, RAM.C7, RAM.D3, RAM.E7, RAM.J9, REG.1, SD.4, ULA.6, ULA.7, ULA.8, ULA.11, ULA.16, ULA.18, ULA.19, ULA.22, ULA.29, ULA.52, ULA.53
5V: AR6.2, C1.2, C2.2, CMP.2, DC24.2, DC25.2, DC26.1, EXTPWR.3, MISC.1, MISC.20, OC.14, R8.2, REG.3, ULA.9, ULA.43, ULA.48
A0_5V: ABUF.H6, ULA.5
A1_5V: ABUF.J6, ULA.1
A2_5V: ABUF.F5, ULA.12
A3_5V: ABUF.C6, ULA.24
A4_5V: ABUF.D5, ULA.21
A5_5V: ABUF.D6, ULA.20
A6_5V: ABUF.E6, ULA.17
A7_5V: ABUF.F6, ULA.15
A8_5V: ABUF.H5, ULA.2
A9_5V: ABUF.B6, ULA.26
A10_5V: ABUF.B5, ULA.25
A11_5V: ABUF.C5, ULA.23
A12_5V: ABUF.G6, ULA.13
A13_5V: ABUF.E5, ULA.14
A14_5V: ABUF.G5, ULA.10
A15_5V: ABUF.A6, ULA.56
A_buf_DIR: ABUF.A3, ABUF.J3, FPGA.B5
A_buf_nOE: ABUF.A4, ABUF.J4, FPGA.A6, PR4.1
CAPS_LOCK_5V: OC.3, ULA.63
CAS_IN_5V: CMP.3, ULA.59
CAS_IN_divider: CMP.4, R7.2, R8.1
CAS_MO_5V: MISC.18, ULA.64
CAS_OUT_5V: MISC.17, ULA.50
D_buf_DIR: DBUF.A3, FPGA.H1
D_buf_nOE: DBUF.A4, FPGA.L4, PR5.1
GND: ABUF.D3, ABUF.D4, ABUF.E3, ABUF.E4, ABUF.F3, ABUF.F4, AC1.2, AC2.2, AC3.2, AC4.2, AC6.2, AC7.2, AC9.2, AR3.2, AR5.2, AUDIO_OUT.1, AUDIO_OUT.3, C1.1, C2.1, C3.2, C4.2, C8.2, C9.2, CMP.5, DAC.4, DAC.13, DBUF.D3, DBUF.D4, DBUF.E3, DBUF.E4, DBUF.F3, DBUF.F4, DC1.2, DC2.2, DC3.2, DC4.2, DC5.2, DC6.2, DC7.2, DC8.2, DC9.2, DC10.2, DC11.2, DC12.2, DC13.2, DC14.2, DC15.2, DC16.1, DC17.1, DC18.1, DC19.1, DC20.1, DC21.1, DC22.1, DC23.1, DC24.1, DC25.1, DC26.2, DC27.1, EXTPWR.1, FLASH.4, FPGA.A1, FPGA.A13, FPGA.B8, FPGA.C3, FPGA.D2, FPGA.D5, FPGA.D7, FPGA.E2, FPGA.E11, FPGA.F3, FPGA.G7, FPGA.H12, FPGA.J4, FPGA.L9, FPGA.M6, FPGA.N1, FPGA.N13, JTAG.2, JTAG.10, JTAGTC.5, MCU.11, MISC.10, MSWD.5, MSWD2.4, MUSB.5, OC.1, OC.5, OC.7, OC.12, OSC.2, R3.2, R7.1, RAM.A1, RAM.A3, RAM.B7, RAM.C3, RAM.D7, RAM.E3, RAM.J1, REG.2, SD.6, SD.SH1, SD.SH2, SERIAL.1, ULA.51, ULA.68, USB.5, staple_single1.1, staple_single2.1, staple_single3.1, staple_single4.1, staple_single5.1, staple_single6.1, staple_single7.1, staple_single8.1, staple_single9.1, staple_single10.1, staple_single11.1, staple_single12.1, staple_single13.1, staple_single14.1, staple_single15.1, staple_single16.1, staple_single17.1, staple_single18.1, staple_single19.1, staple_single20.1, staple_single21.1, staple_single22.1, staple_single23.1, staple_single24.1, staple_single25.1, staple_single26.1, staple_single27.1, staple_single28.1, staple_single29.1, staple_single30.1, staple_single31.1, staple_single32.1, staple_single33.1, staple_single34.1, staple_single35.1, staple_single36.1, staple_single37.1, staple_single38.1, staple_single39.1, staple_single40.1, staple_single41.1, staple_single42.1, staple_single43.1, staple_single44.1, staple_single45.1, staple_single46.1, staple_single47.1, staple_single48.1, staple_single49.1, staple_single50.1, staple_single51.1, staple_single52.1, staple_single53.1
HS_n: FPGA.B10, MISC.6
IRQ_n_in: DBUF.G1, FPGA.E1
IRQ_n_out: FPGA.C13, OC.13, PR9.1
KBD0_5V: DBUF.J6, ULA.27
KBD1_5V: DBUF.H6, ULA.28
KBD2_5V: DBUF.G5, ULA.31
KBD3_5V: DBUF.F6, ULA.32
NMI_n_in: DBUF.H2, FPGA.F4
PD0_5V: DBUF.E5, ULA.33
PD1_5V: DBUF.C5, ULA.35
PD2_5V: DBUF.D6, ULA.36
PD3_5V: DBUF.D5, ULA.38
PD4_5V: DBUF.B5, ULA.39
PD5_5V: DBUF.B6, ULA.41
PD6_5V: DBUF.C6, ULA.42
PD7_5V: DBUF.A6, ULA.45
PHI_OUT_5V: C4.1, R5.2, ULA.60
PHI_OUT_5V_prefilter: MISC.11, R5.1
ROM_n: FPGA.E4, ULA.61
RST_n_in: D1.2, FPGA.L2, PR14.2
RST_n_out: FPGA.B12, OC.4, PR8.1
RnW_5V: DBUF.F5, OC.8, ULA.46
RnW_in: DBUF.F2, FPGA.H3
RnW_nOE: FPGA.C12, OC.10, PR10.1
RnW_out: FPGA.B13, OC.9
SOUND_OUT_5V: AC8.2, AR4.1, ULA.62
USBDM: R9.1, USB.2
USBDP: R10.1, R11.1, USB.3
USB_M: FPGA.E13, R9.2
USB_P: FPGA.D11, R10.2
USB_PU: FPGA.D12, R11.2
addr0: ABUF.H1, FPGA.B4
addr1: ABUF.J1, FPGA.A5
addr2: ABUF.F2, FPGA.C9
addr3: ABUF.C1, FPGA.B3
addr4: ABUF.D2, FPGA.F8
addr5: ABUF.D1, FPGA.E6
addr6: ABUF.E1, FPGA.E8
addr7: ABUF.F1, FPGA.D9
addr8: ABUF.H2, FPGA.A4
addr9: ABUF.B1, FPGA.B1
addr10: ABUF.B2, FPGA.B2
addr11: ABUF.C2, FPGA.A2
addr12: ABUF.G1, FPGA.C10
addr13: ABUF.E2, FPGA.E9
addr14: ABUF.G2, FPGA.A3
addr15: ABUF.A1, FPGA.C2
audio_bias: AC9.1, AR4.2, AR5.1, AR6.1
audio_out_left: AC6.1, AR1.2, AUDIO_OUT.4
audio_out_right: AC7.1, AR2.2, AUDIO_OUT.2
blue: FPGA.A9, MISC.4
blue_5V: MISC.16, ULA.66
caps: FPGA.C11, OC.2
casIn: CMP.1, FPGA.M1, R6.1
casMO: FPGA.A7, MISC.2
casOut: FPGA.A8, MISC.3
clk_in: DBUF.E1, FPGA.H4
clk_in_5V: DBUF.E6, ULA.49
clk_osc: FPGA.G9, OSC.3
clk_out: FPGA.A12, MISC.9
csync: FPGA.A10, MISC.5
csync_5V: MISC.15, ULA.65
dac_bclk: DAC.9, FPGA.M2
dac_dacdat: DAC.7, FPGA.M3
dac_lrclk: DAC.8, FPGA.N2
dac_mclk: DAC.10, FPGA.L3
dac_nmute: DAC.11, FPGA.L1
dac_out_left: AR1.1, DAC.1
dac_out_right: AC8.1, AR2.1, AR3.1, DAC.16
dac_power_cpca: AC5.1, DAC.5
dac_power_cpcb: AC5.2, DAC.3
dac_power_cpvoutn: AC1.1, DAC.2
dac_power_vmid: AC4.1, DAC.14
data0: DBUF.E2, FPGA.H2
data1: DBUF.C2, FPGA.H6
data2: DBUF.D1, FPGA.G4
data3: DBUF.D2, FPGA.J2
data4: DBUF.B2, FPGA.H5
data5: DBUF.B1, FPGA.K2
data6: DBUF.C1, FPGA.J1
data7: DBUF.A1, FPGA.K1
flash_IO0: FLASH.5, FPGA.J12
flash_IO1: FLASH.2, FPGA.F12
flash_IO2: FLASH.3, FPGA.G13
flash_IO3: FLASH.7, FPGA.G12
flash_SCK: FLASH.6, FPGA.H13
flash_nCE: FLASH.1, FPGA.F13, PR1.1
fpga_CONF_DONE: FPGA.C5, PR12.1
fpga_TCK: FPGA.G2, JTAG.1, JTAGTC.4, R3.1
fpga_TDI: FPGA.F5, JTAG.9, JTAGTC.3
fpga_TDO: FPGA.F6, JTAG.3, JTAGTC.6
fpga_TMS: FPGA.G1, JTAG.5, JTAGTC.2
fpga_nSTATUS: FPGA.C4, PR13.1
green: FPGA.A11, MISC.7
green_5V: MISC.13, ULA.4
input_buf_nOE: DBUF.J4, FPGA.D1, PR6.1
kbd0: DBUF.J1, FPGA.C1
kbd1: DBUF.H1, FPGA.E3
kbd2: DBUF.G2, FPGA.G5
kbd3: DBUF.F1, FPGA.F1
mcu_MISO: FPGA.E5, MCU.3, MSWD2.7
mcu_MOSI: FPGA.B9, MCU.14, MSWD2.11
mcu_PA02: MCU.13, MSWD2.12
mcu_RESET: MCU.6, MSWD.3, MSWD2.5, PR15.1
mcu_SCK: FPGA.D8, MCU.1, MSWD2.9
mcu_SS: FPGA.D6, MCU.2, MSWD2.10
mcu_SWCLK: MCU.7, MR2.1, MSWD.4, MSWD2.3
mcu_SWDIO: MCU.8, MSWD.2, MSWD2.1
mcu_USBDM: MCU.9, MUSB.2
mcu_USBDP: MCU.10, MUSB.3
mcu_debug_RXD: FPGA.B7, MCU.5, MSWD2.6
mcu_debug_TXD: FPGA.D13, MCU.4, MSWD2.8
misc_buf_nOE: FPGA.B6, MISC.19, PR7.1
nHS_5V: MISC.14, ULA.67
nIRQ_5V: DBUF.G6, OC.11, ULA.30
nNMI_5V: DBUF.H5, ULA.57
nRESET_5V: D1.1, OC.6, ULA.58
red: FPGA.B11, MISC.8
red_5V: MISC.12, ULA.3
sd_CLK_SCK: FPGA.G10, SD.5
sd_CMD_MOSI: FPGA.F10, PR11.2, SD.3
sd_DAT0_MISO: FPGA.H10, SD.7
sd_DAT1: FPGA.E12, SD.8
sd_DAT2: FPGA.F9, SD.1
sd_DAT3_nCS: FPGA.E10, PR3.1, SD.2
sdram_A0: FPGA.M9, RAM.H7
sdram_A1: FPGA.K7, RAM.H8
sdram_A2: FPGA.N7, RAM.J8
sdram_A3: FPGA.N8, RAM.J7
sdram_A4: FPGA.H9, RAM.J3
sdram_A5: FPGA.L10, RAM.J2
sdram_A6: FPGA.J9, RAM.H3
sdram_A7: FPGA.N10, RAM.H2
sdram_A8: FPGA.M11, RAM.H1
sdram_A9: FPGA.J8, RAM.G3
sdram_A10: FPGA.M7, RAM.H9
sdram_A11: FPGA.K10, RAM.G2
sdram_A12: FPGA.N12, RAM.G1
sdram_BA0: FPGA.N9, RAM.G7
sdram_BA1: FPGA.K8, RAM.G8
sdram_CKE: FPGA.M10, RAM.F3
sdram_CLK: FPGA.H8, RAM.F2
sdram_DQ0: FPGA.J5, RAM.A8
sdram_DQ1: FPGA.K5, RAM.B9
sdram_DQ2: FPGA.J6, RAM.B8
sdram_DQ3: FPGA.N3, RAM.C9
sdram_DQ4: FPGA.M4, RAM.C8
sdram_DQ5: FPGA.N4, RAM.D9
sdram_DQ6: FPGA.K6, RAM.D8
sdram_DQ7: FPGA.M5, RAM.E9
sdram_DQ8: FPGA.J10, RAM.E1
sdram_DQ9: FPGA.L11, RAM.D2
sdram_DQ10: FPGA.M13, RAM.D1
sdram_DQ11: FPGA.L12, RAM.C2
sdram_DQ12: FPGA.L13, RAM.C1
sdram_DQ13: FPGA.K12, RAM.B2
sdram_DQ14: FPGA.K11, RAM.B1
sdram_DQ15: FPGA.J13, RAM.A2
sdram_LDQM: FPGA.N5, RAM.E8
sdram_UDQM: FPGA.M12, RAM.F1
sdram_nCAS: FPGA.M8, RAM.F7
sdram_nCS: FPGA.N6, PR2.1, RAM.G9
sdram_nRAS: FPGA.L5, RAM.F8
sdram_nWE: FPGA.J7, RAM.F9
serial_RXD: FPGA.N11, SERIAL.3
serial_TXD: FPGA.K13, SERIAL.2
