hoglet67/ElectronFpga/rgb_to_vga_pcb/rgb_to_vga.kicad_pcb

## KiCad design rgb_to_vga_pcb/rgb_to_vga.kicad_pcb (2020-06-26)

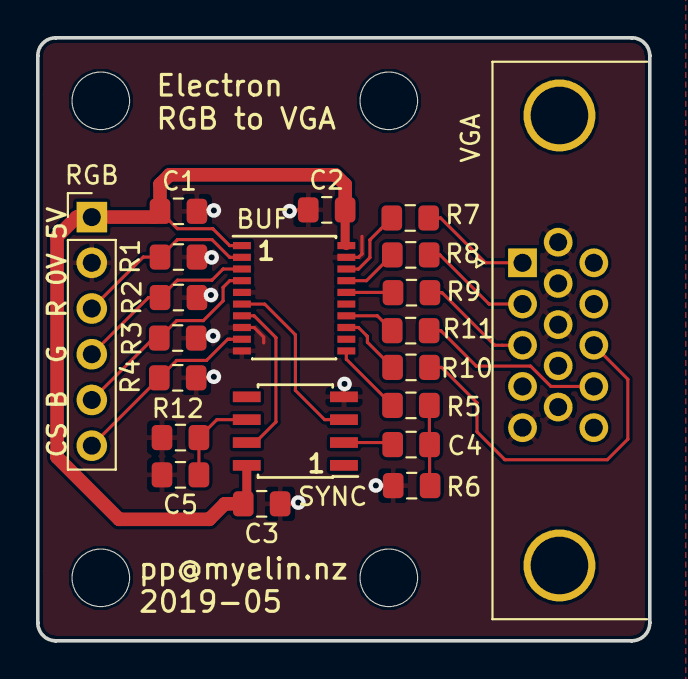
[picture p10: board rgb_to_vga.kicad_pcb from above]

Board: 2 copper layers, 34.0 x 33.5 mm, 21 parts (0 on the bottom side), 22 nets.

Parts:
BUF: 74HCT245PW; SSOP-20_4.4x6.5mm_P0.65mm
C1: 10u; C_0805_2012Metric_Pad1.15x1.40mm_HandSolder
C2, C3, C4, C5: 100n; C_0805_2012Metric_Pad1.15x1.40mm_HandSolder
R1, R2, R3, R4: 10k NF; R_0805_2012Metric_Pad1.15x1.40mm_HandSolder
R5: 4k TBD; R_0805_2012Metric_Pad1.15x1.40mm_HandSolder
R6: 1k TBD; R_0805_2012Metric_Pad1.15x1.40mm_HandSolder
R7, R8, R9: 480R; R_0805_2012Metric_Pad1.15x1.40mm_HandSolder
R10, R11: 100R; R_0805_2012Metric_Pad1.15x1.40mm_HandSolder
R12: 681k 1%; R_0805_2012Metric_Pad1.15x1.40mm_HandSolder
RGB: RGB; PinHeader_1x06_P2.54mm_Vertical
SYNC: EL1883; SOIC-8_3.9x4.9mm_P1.27mm
VGA: VGA; DSUB-15-HD_Female_Horizontal_P2.29x1.98mm_EdgePinOffset3.03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

Connections:
5V: BUF.1, BUF.20, C1.2, C2.2, C3.2, RGB.1, SYNC.8
B_buf: BUF.16, R9.1
B_in: BUF.4, R3.1, RGB.5
B_out: R9.2, VGA.3
CS_buf: BUF.11, R5.1
CS_coupled: C4.2, SYNC.2
CS_divided: C4.1, R5.2, R6.1
CS_in: BUF.9, R4.1, RGB.6
GND: BUF.5, BUF.8, BUF.10, BUF.19, C1.1, C2.1, C3.1, C5.2, R1.2, R2.2, R3.2, R4.2, R6.2, R12.2, RGB.2, SYNC.4, VGA.5, VGA.6, VGA.7, VGA.8, VGA.10
G_buf: BUF.17, R8.1
G_in: BUF.3, R2.1, RGB.4
G_out: R8.2, VGA.2
HS: BUF.7, SYNC.7
HS_buf: BUF.13, R10.1
HS_out: R10.2, VGA.13
RSET: C5.1, R12.1, SYNC.6
R_buf: BUF.18, R7.1
R_in: BUF.2, R1.1, RGB.3
R_out: R7.2, VGA.1
VS: BUF.6, SYNC.3
VS_buf: BUF.14, R11.1
VS_out: R11.2, VGA.14
