hoglet67/ElectronFpga/gowin/ElectronFpga_TangNano20K/src/mem_tang_20k.vhd

library ieee;
use ieee.std_logic_1164.all;
use ieee.std_logic_unsigned.all;
use ieee.numeric_std.all;
use std.textio.all;

library work;

entity mem_tang_20k is
    generic (
        PRJ_ROOT             : string;
        MOS_NAME             : string;
        SIM                  : boolean;
        IncludeMonitor       : boolean := false;
        IncludeBootstrap     : boolean

        );
    port(
        CLK_96            : in  std_logic;
        CLK_96_P          : in  std_logic;
        CLK_48            : in  std_logic;

        rst_n             : in  std_logic;

        READY             : out std_logic;

        core_rfsh_stb     : in    std_logic;
        core_A_stb        : in    std_logic;
        core_A            : in    std_logic_vector (18 downto 0);
        core_Din          : in    std_logic_vector (7 downto 0);
        core_Dout         : out   std_logic_vector (7 downto 0);
        core_nCS          : in    std_logic;
        core_nWE          : in    std_logic;
        core_nWE_long     : in    std_logic;
        core_nOE          : in    std_logic;

        O_sdram_clk       : out   std_logic;
        O_sdram_cke       : out   std_logic;
        O_sdram_cs_n      : out   std_logic;
        O_sdram_cas_n     : out   std_logic;
        O_sdram_ras_n     : out   std_logic;
        O_sdram_wen_n     : out   std_logic;
        IO_sdram_dq       : inout std_logic_vector(31 downto 0);
        O_sdram_addr      : out   std_logic_vector(10 downto 0);
        O_sdram_ba        : out   std_logic_vector(1 downto 0);
        O_sdram_dqm       : out   std_logic_vector(3 downto 0);

        led               : out   std_logic_vector(5 downto 0);

        FLASH_CS          : out   std_logic;                     -- Active low FLASH chip select
        FLASH_SI          : out   std_logic;                     -- Serial output to FLASH chip SI pin
        FLASH_CK          : out   std_logic;                     -- FLASH clock
        FLASH_SO          : in    std_logic                      -- Serial input from FLASH chip SO pin
        );
end mem_tang_20k;

architecture rtl of mem_tang_20k is

    constant ROMSIZE : natural := 32768;

    type mem_mos_t is array(0 to ROMSIZE-1) of std_logic_vector(7 downto 0);

    impure function MEM_INIT_FILE(file_name:STRING) return mem_mos_t is
        FILE infile : text is in file_name;
        variable arr : mem_mos_t := (others => (others => '0'));
        variable inl : line;
        variable count : integer;
    begin
        if not IncludeBootstrap then
            count := 0;
            while not(endfile(infile)) and count < ROMSIZE loop
                readline(infile, inl);
                read(inl, arr(count));
                count := count + 1;
            end loop;
        end if;

        return arr;
    end function;

    signal r_mem_rom : mem_mos_t := MEM_INIT_FILE(PRJ_ROOT & MOS_NAME);

    -- sdram controller
    signal i_sdram_cmd_read    : std_logic;
    signal i_sdram_cmd_write   : std_logic;
    signal i_sdram_cyc         : std_logic;
    signal i_sdram_we          : std_logic;
    signal i_sdram_addr        : std_logic_vector(22 downto 0);
    signal i_sdram_din         : std_logic_vector(7 downto 0);
    signal i_sdram_dout        : std_logic_vector(7 downto 0);
    signal i_sdram_busy        : std_logic;

    -- from bootstrap to sdram controller
    signal i_X_Din         : std_logic_vector(7 downto 0);
    signal i_X_Dout        : std_logic_vector(7 downto 0);
    signal i_X_A_stb       : std_logic;
    signal i_X_A           : std_logic_vector(18 downto 0);
    signal i_X_nWE_long    : std_logic;
    signal i_X_nOE         : std_logic;
    signal i_X_nCS         : std_logic;

-----------------------------------------------
-- Bootstrap ROM Image from SPI FLASH into SRAM
-----------------------------------------------

    constant   user_rom_map                 : std_logic_vector(63 downto 0) := x"FEDCBA9876543210";
    constant   user_address                 : std_logic_vector(23 downto 0) := x"5C0000";
    constant   user_length                  : std_logic_vector(23 downto 0) := x"040000"; -- 256KB

    -- high when FLASH is being copied to SRAM, can be used by user as active high reset
    signal   i_bootstrap_busy  : std_logic;

    signal   i_bootstrap_reset_n  : std_logic;


    -- Signals for the bootstrap health monitor
    signal ADDR_INS0 : std_logic_vector(18 downto 0);
    signal ADDR_INS1 : std_logic_vector(18 downto 0);
    signal ADDR_VEC0 : std_logic_vector(18 downto 0);
    signal ADDR_VEC1 : std_logic_vector(18 downto 0);

    signal DATA_INS0 : std_logic_vector(7 downto 0);
    signal DATA_INS1 : std_logic_vector(7 downto 0);
    signal DATA_VEC0 : std_logic_vector(7 downto 0);
    signal DATA_VEC1 : std_logic_vector(7 downto 0);

    -- Bit 5 is the error bit
    -- Bit 4 is the done bit
    -- Bit 3 is the write/read bit (0 = write, 1 = read)

    constant DBG_00 : std_logic_vector(5 downto 0) := "000000";
    constant DBG_01 : std_logic_vector(5 downto 0) := "000001";
    constant DBG_02 : std_logic_vector(5 downto 0) := "000010";
    constant DBG_03 : std_logic_vector(5 downto 0) := "000011";
    constant DBG_04 : std_logic_vector(5 downto 0) := "000100";
    constant DBG_05 : std_logic_vector(5 downto 0) := "000101";
    constant DBG_06 : std_logic_vector(5 downto 0) := "000110";
    constant DBG_07 : std_logic_vector(5 downto 0) := "000111";
    constant DBG_08 : std_logic_vector(5 downto 0) := "001000";
    constant DBG_09 : std_logic_vector(5 downto 0) := "001001";
    constant DBG_0A : std_logic_vector(5 downto 0) := "001010";
    constant DBG_0B : std_logic_vector(5 downto 0) := "001011";
    constant DBG_0C : std_logic_vector(5 downto 0) := "001100";
    constant DBG_0D : std_logic_vector(5 downto 0) := "001101";
    constant DBG_0E : std_logic_vector(5 downto 0) := "001110";
    constant DBG_0F : std_logic_vector(5 downto 0) := "001111";
    constant DBG_DONE : std_logic_vector(5 downto 0) := "011111";
    signal   state  : std_logic_vector(5 downto 0) := DBG_00;

    signal ctl_rfsh_i   : std_logic;
    signal ctl_reset_i  : std_logic;
    signal ctl_cyc_i    : std_logic;
    signal ctl_we_i     : std_logic;

begin

    -- Synchronise SD Ram control inputs to 96MHz clock
    process(CLK_96)
    begin
        if rising_edge(CLK_96) then
            ctl_reset_i  <= not rst_n;
            ctl_rfsh_i   <= core_rfsh_stb;
            ctl_cyc_i    <= i_sdram_cyc;
            ctl_we_i     <= i_sdram_we;
        end if;
    end process;

    sdram_ctl : entity work.sdramctl
    generic map (
        CLOCKSPEED  => 96000000,
        T_CAS_EXTRA => 1,

        -- SDRAM geometry
        LANEBITS    => 2,   -- number of byte lanes bits, if 0 don't connect sdram_DQM_o
        BANKBITS    => 2,   -- number of bits, if none set to 0 and don't connect sdram_BS_o
        ROWBITS     => 11,
        COLBITS     => 8,

        -- SDRAM speed
        trp             => 15 ns,    -- precharge
        trcd            => 15 ns,    -- active to read/write
        trc             => 60 ns,    -- active to active time
        trfsh           => 1.8 us,   -- the refresh control signal will be blocked if it occurs more frequently than this
        trfc            => 63 ns     -- refresh cycle time


        )
    port map (
        Clk          => CLK_96,

        sdram_DQ_io  => IO_sdram_dq,
        sdram_A_o    => O_sdram_addr,
        sdram_BS_o   => O_sdram_ba,
        sdram_CKE_o  => O_sdram_cke,
        sdram_nCS_o  => O_sdram_cs_n,
        sdram_nRAS_o => O_sdram_ras_n,
        sdram_nCAS_o => O_sdram_cas_n,
        sdram_nWE_o  => O_sdram_wen_n,
        sdram_DQM_o  => O_sdram_dqm,

        ctl_rfsh_i   => ctl_rfsh_i ,
        ctl_reset_i  => ctl_reset_i,
        ctl_stall_o  => i_sdram_busy,
        ctl_cyc_i    => ctl_cyc_i,
        ctl_we_i     => ctl_we_i,
        ctl_A_i      => i_sdram_addr,
        ctl_D_wr_i   => i_sdram_din,
        ctl_D_rd_o   => i_sdram_dout,
        ctl_ack_o    => open
        );

    O_sdram_clk <= CLK_96_P;

    -- Controls for NESTang Controller
    i_sdram_cmd_read  <= not(i_X_nCS) and i_X_A_stb and not i_X_nOE;
    i_sdram_cmd_write <= not(i_X_nCS) and i_X_A_stb and not i_X_nWE_long;

    -- Controls for Dominic SDRAM Controller
    i_sdram_cyc  <= not(i_X_nCS) and i_X_A_stb;
    i_sdram_we   <= not i_X_nWE_long;

    -- SDRAM address is structured as:
    --   bits 22..21 are the bank (4 banks)
    --   bits 20..10 are the row (2048 rows)
    --   bits 9..2 are the column (256 cols)
    --   bits 1..0 are the byte offset (selecting 8 bits out of 32)
    -- i_X_A(9:0) is the BBC refresh address: feed this in as the row
    i_sdram_addr <= "000" & i_X_A(9 downto 0) & "0" & i_X_A(18 downto 10);
    i_sdram_din <= i_X_Din;

    p_reset:process(CLK_48, rst_n)
    begin
        if rst_n = '0' then
            READY <= '0';
            i_bootstrap_reset_n <= '0';
        elsif rising_edge(CLK_48) then
            if i_sdram_busy = '0' then
                i_bootstrap_reset_n <= '1';
            end if;
            READY <= not i_bootstrap_busy;
        end if;
    end process;


--------------------------------------------------------
-- BOOTSTRAP SPI FLASH to SRAM
--------------------------------------------------------

    GenBootstrap: if IncludeBootstrap generate

        inst_bootstrap: entity work.bootstrap
            port map(
                clock           => CLK_48,
                powerup_reset_n => i_bootstrap_reset_n,
                bootstrap_busy  => i_bootstrap_busy,
                user_address    => user_address,
                user_length     => user_length,
                user_rom_map    => user_rom_map,
                RAM_A_stb       => core_A_stb,
                RAM_nOE         => core_nOE,
                RAM_nWE         => core_nWE,
                RAM_nWE_long    => core_nWE_long,
                RAM_nCS         => core_nCS,
                RAM_A           => core_A,
                RAM_Din         => core_Din,
                RAM_Dout        => core_Dout,
                SRAM_A_stb      => i_X_A_stb,
                SRAM_nOE        => i_X_nOE,
                SRAM_nWE        => open,
                SRAM_nWE_long   => i_X_nWE_long,
                SRAM_nCS        => i_X_nCS,
                SRAM_A          => i_X_A,
                SRAM_D_out      => i_X_Din,
                SRAM_D_in       => i_X_Dout,
                FLASH_CS        => FLASH_CS,
                FLASH_SI        => FLASH_SI,
                FLASH_CK        => FLASH_CK,
                FLASH_SO        => FLASH_SO
                );

        i_X_Dout <= i_sdram_dout;

    end generate;

    NotGenBootstrap: if not IncludeBootstrap generate

        i_bootstrap_busy <= '0';
        i_X_A_stb      <= core_A_stb;
        i_X_nOE        <= core_nOE;
        i_X_nWE_long   <= core_nWE_long;
        i_X_nCS        <= core_nCS;
        i_X_A          <= core_A;
        i_X_Din        <= core_Din;
        core_Dout      <= i_X_Dout;

        FLASH_CS       <= '1';
        FLASH_SI       <= '1';
        FLASH_CK       <= '1';

        -- Minimal Electron ROM Set (
        p_ram_rd:process(CLK_48)
        begin
            if rising_edge(CLK_48) then
                if core_A(18 downto 16) = "010" then
                    -- OS12 in slots 8/9 and Basic2 in slots A/B
                    i_X_Dout <= r_mem_rom(to_integer(unsigned(core_A(15) & core_A(13 downto 0))));
                else
                    i_X_Dout <= i_sdram_dout(7 downto 0);
                end if;
            end if;
        end process;
    end generate;

    --------------------------------------------------------
    -- Statemachine for debugging bootstrap failures
    --------------------------------------------------------

    mon : if IncludeMonitor generate

         -- Notes:
        --
        --   The monitor runs from the system clock domain (CLK_48)
        --   not the memory clock domain, so it better checks what
        --   bbc_micro_core sees.
        --
        --   Writes are checked at the start of the memory access.
        --
        --   Reads need to be checked at the end of the memory access,
        --   when the read data is avilable. It's problematic to use
        --   the data ready signal as a trigger, as the memory clock
        --   is faster (CLK_96), so sampling this back to CLK_48 is
        --   unreliable. So instead we check a fixed amount (5 system
        --   clocks cycle) later. This matches how bbc_micro_core
        --   latches the read data at the end of the 6 cycle memory
        --   access slot.

        ADDR_INS0 <= "010" & x"18D2";
        ADDR_INS1 <= "010" & x"18D3";
        ADDR_VEC0 <= "010" & x"3FFC";
        ADDR_VEC1 <= "010" & x"3FFD";

        DATA_INS0 <= x"A9";
        DATA_INS1 <= x"40";
        DATA_VEC0 <= x"D2";
        DATA_VEC1 <= x"D8";

        process(CLK_48)
            variable test_write : std_logic;
            variable test_read  : std_logic;
            variable read_delay : std_logic_vector(2 downto 0);
        begin
            if rising_edge(CLK_48) then
                if rst_n = '0' then
                    state <= DBG_00;
                else
                    case (state) is
                        when DBG_00 =>
                            if IncludeBootstrap then
                                state <= DBG_01;
                            else
                                state <= DBG_09;
                            end if;
                        when DBG_01 =>
                            if rst_n = '1' then
                                state <= DBG_02;
                            end if;
                        when DBG_02 =>
                            if i_bootstrap_reset_n = '0' then
                                state <= DBG_03;
                            end if;
                        when DBG_03 =>
                            -- The i_X_A term skips over the bootstrap writing zeros
                            if i_bootstrap_reset_n = '1' and test_write = '1' and i_X_A = ADDR_VEC1 then
                                state <= DBG_04;
                            end if;
                        when DBG_04 =>
                            if test_write = '1' then
                                if i_X_A = ADDR_INS0 then
                                    if i_X_Din = DATA_INS0 then
                                        state <= DBG_05;
                                    else
                                        state(5) <= '1';
                                    end if;
                                end if;
                            end if;
                        when DBG_05 =>
                            if test_write = '1' then
                                if i_X_A = ADDR_INS1 then
                                    if i_X_Din = DATA_INS1 then
                                        state <= DBG_06;
                                    else
                                        state(5) <= '1';
                                    end if;
                                end if;
                            end if;
                        when DBG_06 =>
                            if test_write = '1' then
                                if i_X_A = ADDR_VEC0 then
                                    if i_X_Din = DATA_VEC0 then
                                        state <= DBG_07;
                                    else
                                        state(5) <= '1';
                                    end if;
                                end if;
                            end if;
                        when DBG_07 =>
                            if  test_write = '1' then
                                if i_X_A = ADDR_VEC1 then
                                    if i_X_Din = DATA_VEC1 then
                                        state <= DBG_08;
                                    else
                                        state(5) <= '1';
                                    end if;
                                end if;
                            end if;
                        when DBG_08 =>
                            if i_bootstrap_busy = '1' then
                                state <= DBG_09;
                            end if;
                        when DBG_09 =>
                            if i_bootstrap_busy = '0' then
                                state <= DBG_0A;
                            end if;
                        when DBG_0A =>
                            if test_read = '1' then
                                if i_X_A = ADDR_VEC0 then
                                    if i_X_Dout = DATA_VEC0 then
                                        state <= DBG_0B;
                                    else
                                        state(5) <= '1';
                                    end if;
                                end if;
                            end if;
                        when DBG_0B =>
                            if test_read = '1' then
                                if i_X_A = ADDR_VEC1 then
                                    if i_X_Dout = DATA_VEC1 then
                                        state <= DBG_0C;
                                    else
                                        state(5) <= '1';
                                    end if;
                                end if;
                            end if;
                        when DBG_0C =>
                            if test_read = '1' then
                                if i_X_A = ADDR_INS0 then
                                    if i_X_Dout = DATA_INS0 then
                                        state <= DBG_0D;
                                    else
                                        state(5) <= '1';
                                    end if;
                                end if;
                            end if;
                        when DBG_0D =>
                            if test_read = '1' then
                                if i_X_A = ADDR_INS1 then
                                    if i_X_Dout = DATA_INS1 then
                                        state <= DBG_DONE;
                                    else
                                        state(5) <= '1';
                                    end if;
                                end if;
                            end if;
                        when others => null;
                    end case;
                end if;
                test_write := i_sdram_cmd_write;
                test_read  := read_delay(0);
                read_delay := i_sdram_cmd_read & read_delay(read_delay'high downto 1);
            end if;
        end process;

        led <= state xor "111111";

    end generate;

    not_mon : if not IncludeMonitor generate

        led <= "111111";

    end generate;

end rtl;
