hoglet67/ElectronFpga/gowin/ElectronFpga_TangNano20K/src/pwm_sddac.vhd

-------------------------------------------------------------------------------
--
-- Delta-Sigma DAC
--
-- Refer to Xilinx Application Note XAPP154.
--
-- This DAC requires an external RC low-pass filter:
--
--   dac_o 0---XXXXX---+---0 analog audio
--              3k3    |
--                    === 4n7
--                     |
--                    GND
--
-------------------------------------------------------------------------------

library ieee;
use ieee.std_logic_1164.all;
use ieee.std_logic_unsigned.all;
use ieee.numeric_std.all;

entity pwm_sddac is
    generic (
        msbi_g : integer := 9
        );
    port (
        clk_i   : in  std_logic;
        reset   : in  std_logic;
        dac_i   : in  std_logic_vector(msbi_g downto 0);
        dac_o   : out std_logic
        );
end pwm_sddac;

architecture rtl of pwm_sddac is
    signal sig_in : unsigned(msbi_g+2 downto 0) := (others => '0');
    signal dac_o_int : std_logic;
begin
    seq: process (clk_i, reset)
    begin
        -- Disabling reset as the DC offset causes a noticable click
        -- if reset = '1' then
        --   sig_in <= to_unsigned(2**(msbi_g+1), sig_in'length);
        --   dac_o_int  <= not dac_o_int;
        -- els
        if rising_edge(clk_i) then
            sig_in <= sig_in + unsigned(sig_in(msbi_g+2) & sig_in(msbi_g+2) & dac_i);
            dac_o_int  <= sig_in(msbi_g+2);
        end if;
    end process seq;
    dac_o <= dac_o_int;
end rtl;
