hoglet67/ElectronFpga/(commit log)

2015-07-30 Implemented all 7 screen modes and the colour palette; slight bug still with log/physical colour 15
    [ElectronULA.vhd]
2015-08-02 Added support for multiple video standards: SVGA@50Hz, SVGA@60Hz and RGB@50Hz
2015-08-03 Updated to latest T65 core which fixed Elite, COLOUR 15 not flashing and double interrupts. Reworked the generation of the Display End and RTC Interrupts to be accurate in both 50Hz and 60Hz modes
    [ElectronULA.vhd]
2015-09-10 Fixed IER bug that was stopping high-tone interrupt from being disabled
    [ElectronULA.vhd]
2015-11-21 Fixed MMC Card at all clock speeds:
    - Updated VIA to latest v004 code from BeebFPGA
    - Fixed clock contention state machine so 1MHz clock never lost sync
    [ElectronFpga_core.vhd]
2015-11-21 Switched over to MMFS as it playes better with AP2
2015-11-22 Switched to SWRAM version of MMFS so page is now &E00 ;-)
2015-11-22 Implemented ABR lock registers; tightened write protection on MMFS
    [ElectronFpga_core.vhd]
2015-11-24 Warning Purge: Made ULA Reset synchronous
    [ElectronULA.vhd]
2015-11-24 Warning Purge: Switched to a PLL to simplify clock routing
2015-11-25 Reworked bootstrap module to be completely synchronous
    [ElectronFpga_duo.vhd]
2016-09-17 Added first working version of standalone Electron ULA design, for the papilio duo prototype
2016-09-17 Changed pin assignment of A0 to avoid conflict with INIT_B
2016-09-17 Fixed a race condition with clearing power on reset as it is begin read
    [ElectronULA.vhd]
2016-09-17 Added a power on reset counter
    [ElectronUla_duo.vhd]
2016-10-01 Electron ULA: Don't make cassette out behaviour depend on motor on
2016-10-03 All: Updated to MMFS 1.29 which fixes an issue with display interrupts being accidentally disabled
2016-10-03 Electron ULA Duo: Fixed Caps LED which had been inverted
    [ElectronUla_duo.vhd]
2016-10-03 Electron ULA: Reworked Cassette Output a bit - now Joe Blade works
    [ElectronULA.vhd]
2016-10-03 Small mistake in last commit
    [ElectronULA.vhd]
2019-02-22 Initial PCB design files -- FPGA netlist, decoupling, and TO DO list.
    [Makefile.pcb, max10_electron_ula.kicad_pcb]
2019-02-22 Added notes on ULA signals, with quotes from Stardot, and added ULA footprint
    [max10_electron_ula.kicad_pcb]
2019-02-23 Added 8MB flash chip
    [max10_electron_ula.kicad_pcb]
2019-02-23 Added 3.3V regulator and capacitors
    [max10_electron_ula.kicad_pcb]
2019-02-23 Added all ULA signals, and some RAM notes
    [max10_electron_ula.kicad_pcb]
2019-02-25 Added SDRAM, and notes on serial flash
    [max10_electron_ula.kicad_pcb]
2019-02-25 Added serial flash chip
    [max10_electron_ula.kicad_pcb]
2019-02-26 Fix for Southern Belle: fire RxFull int when tape output mode is entered
    [ElectronULA.vhd]
2019-03-01 Audio DAC, and a small pile of resistors and capacitors
2019-03-22 Netlist is getting there -- now all buffers are connected up on the 5V side, and all pullups/decoupling discretes are in there, I think
    [max10_electron_ula.kicad_pcb]
2019-03-25 Fan out for FPGA more or less done -- time to assign pins
    [max10_electron_ula.kicad_pcb]
2019-03-31 Added all signals to FPGA -- pins not properly assigned yet; just to make sure they'll fit at all.
    [max10_electron_ula.kicad_pcb]
2019-05-04 Making progress wiring up all the signals inside the ULA socket
    [max10_electron_ula.kicad_pcb]
2019-05-05 Provisional FPGA pinout -- still need to check high/low speed pins, but it'll be similar to this
    [max10_electron_ula.kicad_pcb]
2019-05-10 Wiring for ULA looking pretty good now -- doing top parts
    [max10_electron_ula.kicad_pcb]
2019-05-10 SDRAM wiring also looking good. Time to verify in Quartus.
    [max10_electron_ula.kicad_pcb]
2019-05-11 Possibly final FPGA pin assignment; PCB looking pretty good too
    [max10_electron_ula.kicad_pcb]
2019-05-11 Slightly more debugging output when building PCB netlist
2019-05-12 Switched to derive_pll_clocks from create_generated_clock to get rid of some Quartus Prime warnings
2019-05-14 v1 candidate 1 -- I think everything is looking pretty good. Compiles OK in Quartus, has plenty of debugging, and the routing is looking all right.
    [max10_electron_ula.kicad_pcb]
2019-05-14 Added EXTPWR and updated TODO list
    [max10_electron_ula.kicad_pcb]
2019-05-20 Final v1 design, sent to JLC last week. Also rgb_to_vga, which buffers RGB signals and separates CSYNC into HSYNC and VSYNC for VGA.
    [max10_electron_ula.kicad_pcb, rgb_to_vga.kicad_pcb]
2019-06-01 Change BOM sorting to make it easier to use for assembly
2019-06-01 Add labels to R/C with uncommon sizes
    [max10_electron_ula.kicad_pcb]
2019-06-01 Finalized PR* names and renamed 10k R1/R2 to PR12/PR13 for consistency
    [max10_electron_ula.kicad_pcb]
2019-06-01 Renamed R4 to PR14 and MR1 to PR15 for consistency
    [max10_electron_ula.kicad_pcb]
2019-06-01 Renamed MC1 to DC27
    [max10_electron_ula.kicad_pcb]
2019-06-01 Update version to v2
    [max10_electron_ula.kicad_pcb]
2019-06-01 Moved some silkscreen labels
    [max10_electron_ula.kicad_pcb]
2019-06-02 Switched to internal version of myelin-kicad.pretty, and updated BOM sort order
2019-06-02 Actually switch to internal myelin_kicad_pcb for better BOM layout
2019-06-14 Tidied up BOM
2019-06-14 Updated PLL to generate 96MHz, added debug SPI for boundary scan, and added debug 115200Hz output on serial_TXD
2019-06-15 Pass MCU SPI port through to serial flash when serial_TXD==0
2019-06-16 firmware_d11 now builds and uploads using arduino-cli with 'make clean upload'
2019-06-19 Moved misc_buf_nOE pullup from 5V to 3V3 so it won't feed 5V into the FPGA
    [max10_electron_ula.kicad_pcb]
2019-06-26 Make CAPS output caps lock status rather than reset
    [ElectronULA_max10.vhd]
2019-06-26 Update PCB TODO
2019-06-28 Flash write works: it was the readback that was the problem
    [firmware_d11.ino]
2019-06-29 Remove timing constraints from other board
2019-07-06 MMFS appears to work; able to correctly reset flash back into QPI mode, but MCU is not having any luck accessing it
    [ElectronULA_max10.vhd, firmware_d11.ino]
2019-07-06 Fixed program_flash.py, and made it pad roms to 64k
    [program_flash.py]
2019-07-06 Autogenerated set_location_assignment values; adding to git so I can spot if I accidentally change anything in the PCB file
2019-07-14 First cut at serial-over-SPI; works in elk->mcu direction but not mcu->elk yet
2019-07-14 Fixed bug in MCU firmware; serial port should now work
    [firmware_d11.ino]
2019-07-28 Change USB VID/PID away from default Atmel values
2019-07-28 Tweaks to Arduino firmware to match ASF4 firmware
2019-08-04 Preparing to switch ports around; tristating mcu_debug_RXD/TXD; more debug outputs for serial_*
2019-11-27 Moved clock generation and address synchronization logic into ElectronULA.vhd; this fixes the keyboard delay, which depends on having access to the address earlier in the cycle.
    [ElectronULA.vhd, ElectronULA_max10.vhd]
2020-01-03 Squashed 'AtomBusMon/' content from commit 50a8672
    git-subtree-dir: AtomBusMon
    git-subtree-split: 50a86721e42e3619a08d2bc8b9e3286a922bef95
    [6502_adapter.kicad_pcb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]
2020-01-03 Fix a ULA bug that messed up the scrolling in 0xC0DE's Basketball Demo
    [ElectronULA.vhd]
2020-01-05 Fix incorrect mode_base for Mode 5
    [ElectronULA.vhd]
2020-01-05 Fixed a ULA bug affecting address wrapping when mode change (affected Firetrack)
    [ElectronULA.vhd]
2020-05-04 Fixed a mode 3/6 screen wrap issue caused by the last commit
    [ElectronULA.vhd]
2020-06-20 Squashed 'AtomBusMon/' changes from 50a8672..ddc2ff3
    ddc2ff3 Updated XPM_T65 to 0.986
    41afa8e Update firmware version to 0.986
    e931e93 6502: fix duplicate break/watchpoints when Rdy in use
    d38ae01 Update firmware version to 0.985
    b07b861 Firmware: add optional address to next command
    2de5c38 6809: fix a bug with write watchpoints seeing data as 0xFF
    85f52ef Update firmware version to 0.984
    46d859f Firware: Fix a race condition when single stepping at slow (<= 1MHz) clock rates
    ac69ecd Update firmware version to 0.983
    9bbefbe 65C02: BE pin now operates as DBE (works in BBC Master)
    11887e8 Update firmware version to 0.982
    6ac7902 Z80: tristate A and D when reset asserted
    git-subtree-dir: Atom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
2020-06-20 ULA: Fix a bug where some ROMs were accessed at 1MHz rather than 2MHz
    [ElectronULA.vhd]
2020-06-21 Squashed 'AtomBusMon/' changes from ddc2ff3..68b34da
    68b34da Update firmware version to 0.987
    ca40fe8 Extend TimerMode command with prescale and reset address
    c0275ff Make commands 6-bits, add Special and TimerMode commands
    git-subtree-split: 68b34da5ba3d25129cca4b5d38e853f6d6360cab
    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
    [6502_adapter.kicad_pcb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]
2020-06-23 ElectronFpga_core: connect video and interrupt signals to test pins
2020-06-23 ULA: fix regression in keyboard timings introduced in 77489cf6
    [ElectronULA.vhd]
2020-06-23 ULA: Revert to original interrupt timings in VGA; this works better with FireTrack
    [ElectronULA.vhd]
2020-06-26 MAX10: Some additionals changes from Phil (see Electron ULA Basic Board thread)
2020-06-26 ULA: Persist changes to turbo_out across resets
    [ElectronULA.vhd]
2020-06-26 ULA: Synchronize changes in the current speed with a 1MHz clock boundary
2020-06-26 MAX10: Work around a bug when the MMFS ROM runs at 2MHz
    [ElectronULA.vhd]
2020-06-27 Revert "MAX10: Work around a bug when the MMFS ROM runs at 2MHz"
    This reverts commit 2f9236fb0c790d9336524789467b74ed698b73e8.
    [ElectronULA.vhd]
2020-06-27 ULA: simplify (and fix bugs in) clock switching logic
    [ElectronULA.vhd]
2020-06-28 ULA: Fix a bug that could stop the clock in 4MHz mode
    [ElectronULA.vhd]
2020-06-28 ULA: revert to original block RAM timing generation
    [ElectronULA.vhd]
2020-06-28 Update to new KiCad, and plan change to debug SPI + serial
    [max10_electron_ula.kicad_pcb]
2020-07-22 ULA: fix that allows 0xC0DE's Vertical Rupture demo to work
    [ElectronULA.vhd]
2020-07-23 ElectronULA: row_addr (qstart on schematics) is a transparent latch
2025-05-10 C code to analyze logic analyzer timing traces
2025-06-19 Core: Fix VHDL 2008 issue (release now reserved)
    [keyboard.vhd]
2025-06-19 Squashed 'AtomBusMon/' changes from a2e2f7c..7d0a837
    7d0a837 65C02: Reset exec_held in MOS6502CpuMonCore (fixes issue with BeebFpga/Gowin)
    0d1a15b 65C02: Minor changes to NOP behaviour
    b9577f5 Updated XPM_T65 to 0.998
    7861329 Update firmware version to 0.998
    220f96b 6502: Treak BRK as a 2-byte opcode
    b96fa11 Update firmware version to 0.997
    08116e5 Routed four test signals to J5
    3e7bda6 Replace special command with x interrupt control commands
    1244eaf .gitignore only
    bf4bef3 Merge branch 'z80_newcore' into dev
    1b0c062 Updated release script to include .bin files
    58978d3 Update build scripts to generate .bin files for programming using OpenOCD on a Pi
    ca285ab Update firmware version to 0.996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
2025-06-19 ROMS: Update AP6 ROM to latest with Tube support
2025-06-19 Tang Nano 20K: Config-1 jumper enables Tube
2025-06-20 ULA: New method for accurate rtc and display interrupts
