hoglet67/ElectronFpga/(notices)

Notices in the files:
AtomBusMon/kicad/z80/v1/z80_adapter.kicad_pcb:
© 2019 Hoglet - Version 1.00
AtomBusMon/kicad/6502/v1/6502_adapter.kicad_pcb:
© 2019 Hoglet - Version 1.10
